Sciguy324/Big-Piano-2/Photos/StickyGuide.jpg

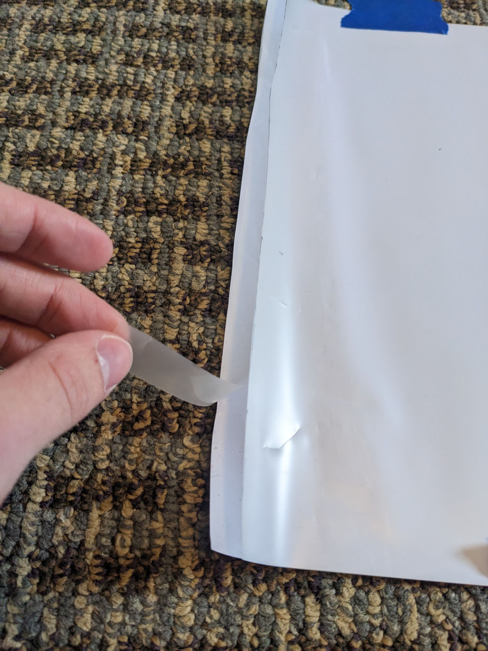
Photos/StickyGuide.jpg
