Sciguy324/Big-Piano-2/Photos/BoardBoxAssembly1.jpg

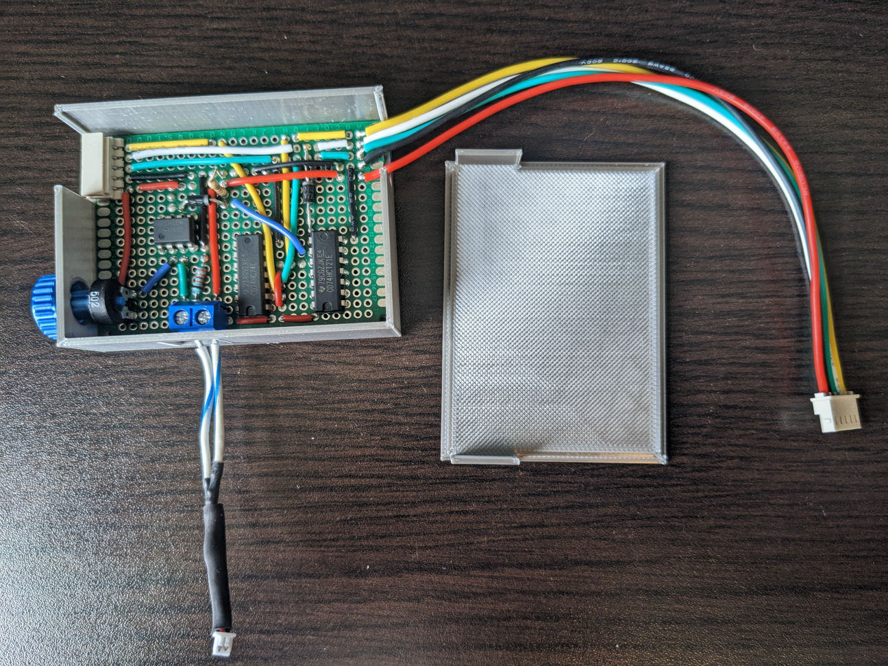
Photos/BoardBoxAssembly1.jpg
