Sciguy324/Big-Piano-2/README.md

# Big-Piano-2
Piano 2 - Electric Boogaloo

This repository contains code and documentation for the Larger Than Life Piano.
