Sciguy324/Big-Piano-2/Photos/BlackKey.jpg

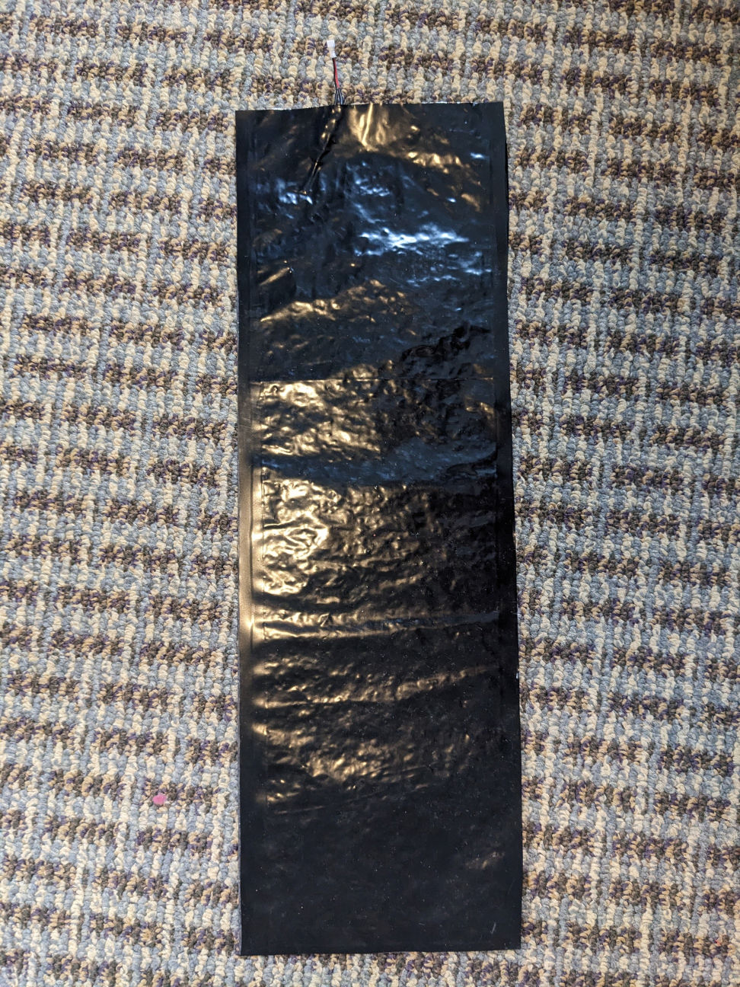
Photos/BlackKey.jpg
