Sciguy324/Big-Piano-2/Photos/BoardBottom.jpg

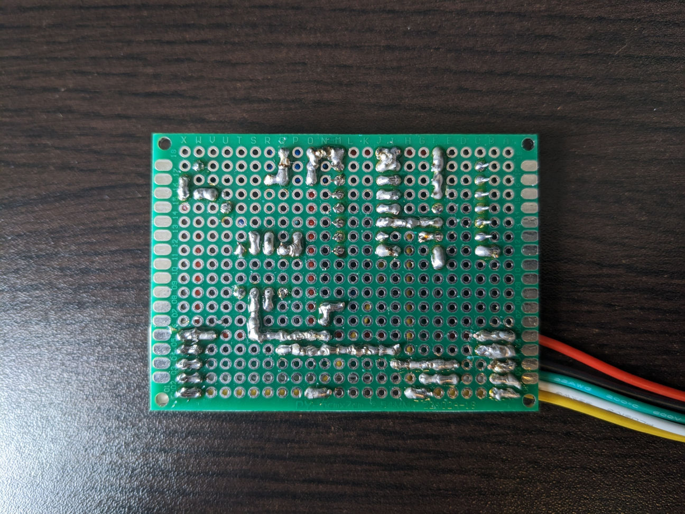
Photos/BoardBottom.jpg
