Sciguy324/Big-Piano-2/Photos/BoardBox.jpg

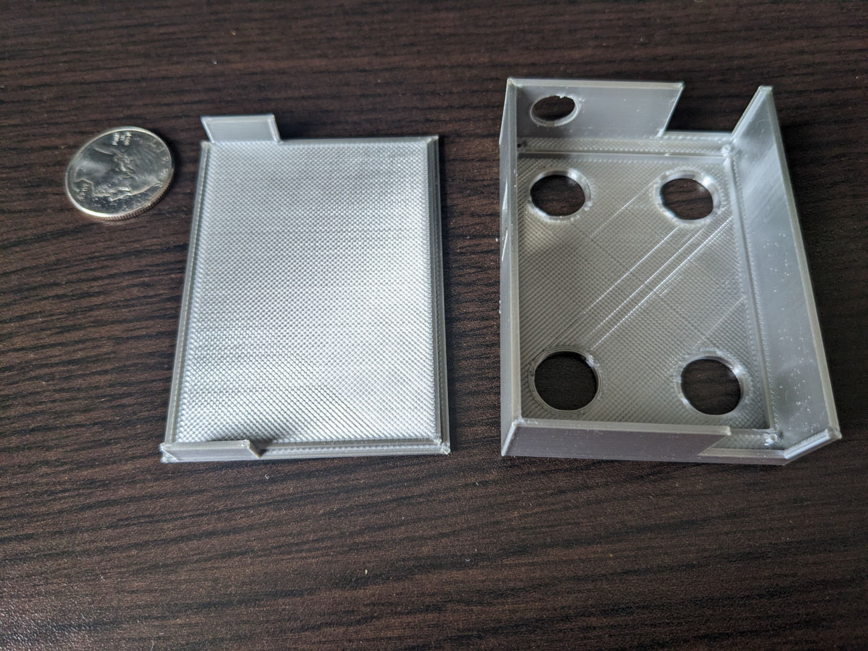
Photos/BoardBox.jpg
