Sciguy324/Big-Piano-2/Photos/BoardsConnected.jpg

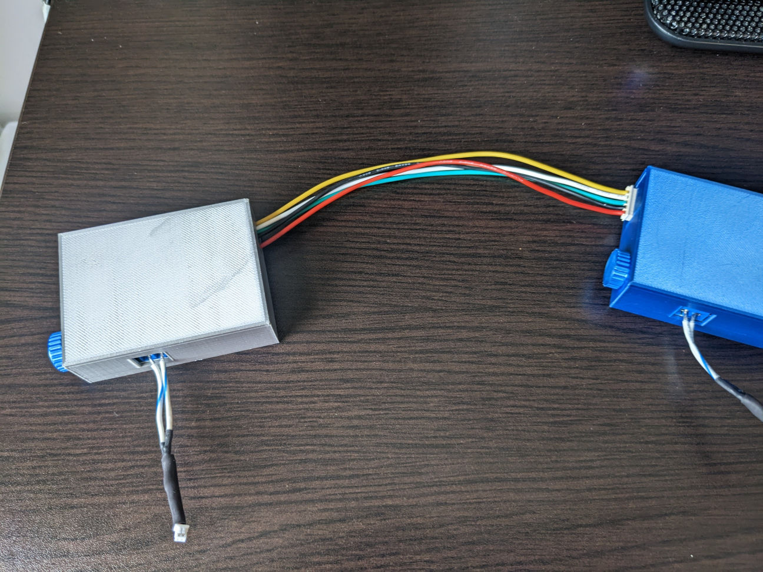
Photos/BoardsConnected.jpg
