Sciguy324/Big-Piano-2/Photos/BoardSide1.jpg

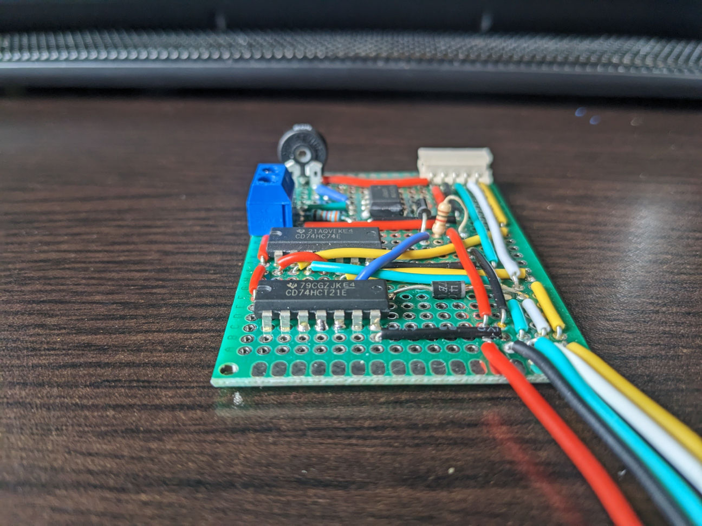
Photos/BoardSide1.jpg
