Sciguy324/Big-Piano-2/Photos/BoardSide2.jpg

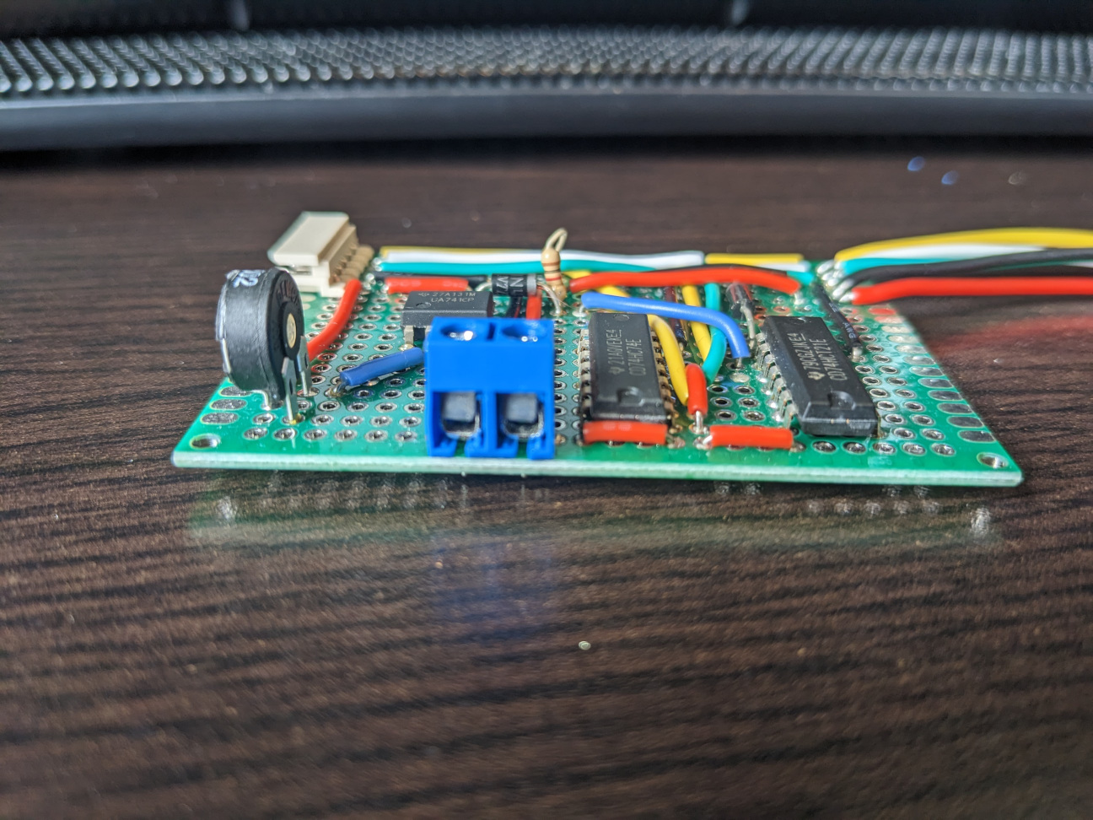
Photos/BoardSide2.jpg
