Sciguy324/Big-Piano-2/Photos/BoardSide3.jpg

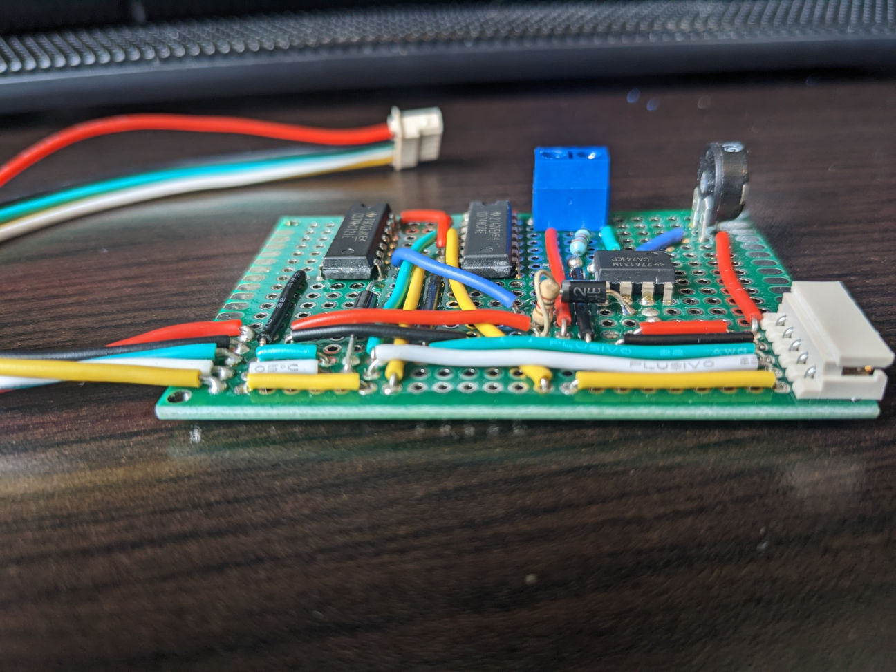
Photos/BoardSide3.jpg
