Sciguy324/Big-Piano-2/Photos/BoardSide4.jpg

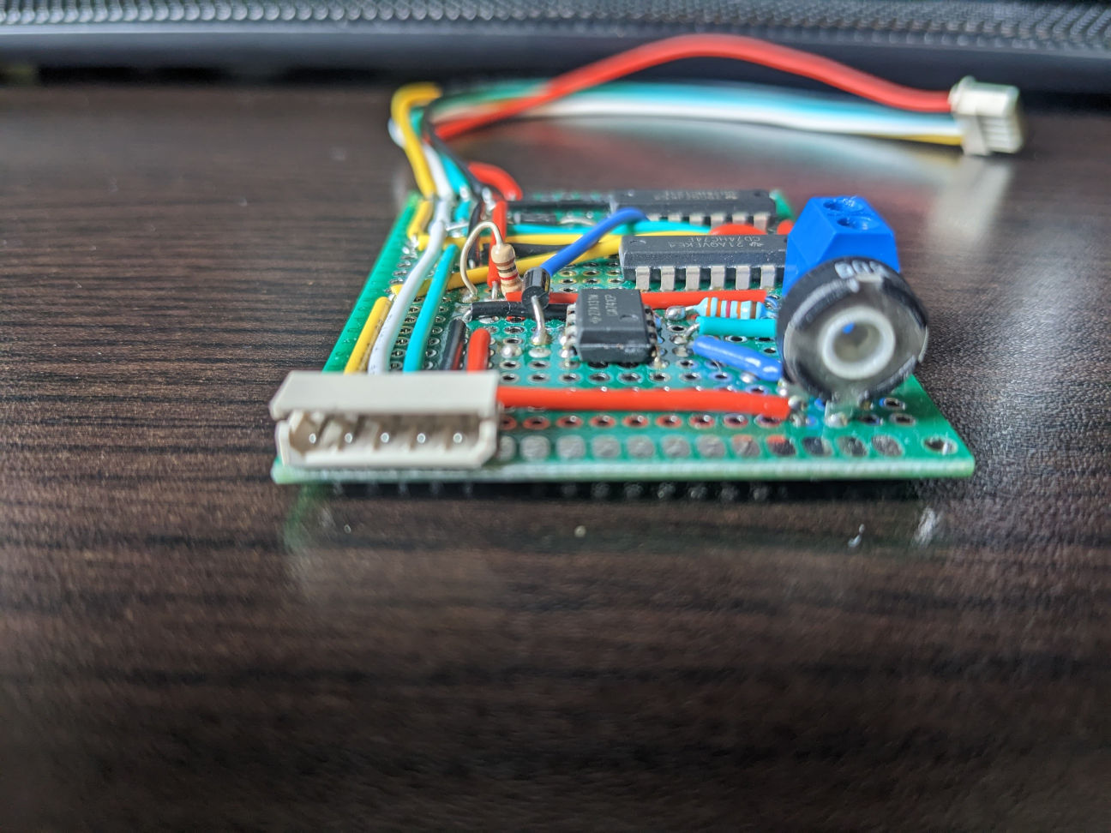
Photos/BoardSide4.jpg
