Sciguy324/Big-Piano-2/Photos/BoardTop1.jpg

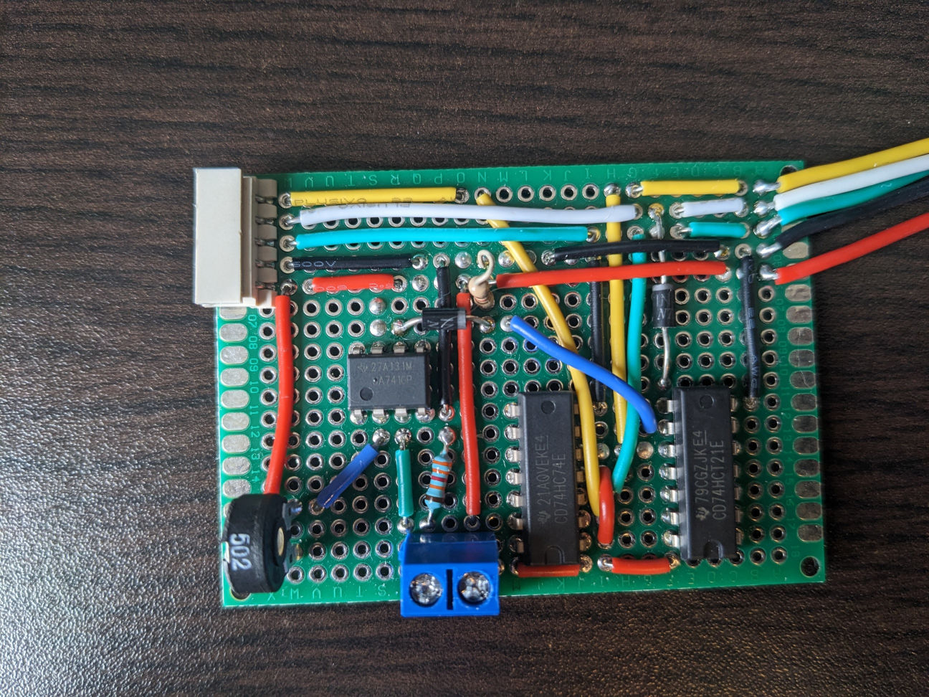
Photos/BoardTop1.jpg
