Sciguy324/Big-Piano-2/Photos/BoardTop2.jpg

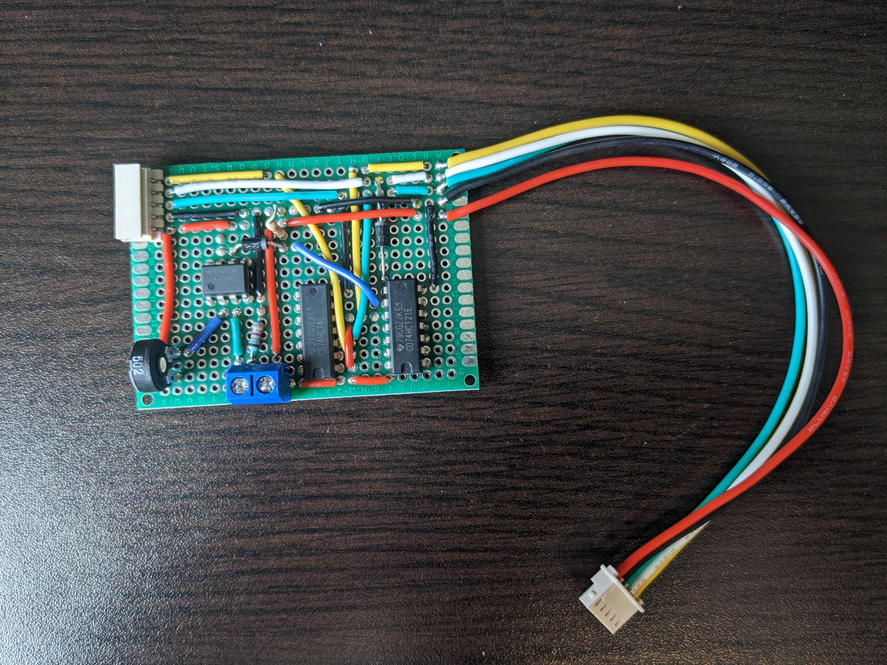
Photos/BoardTop2.jpg
