Sciguy324/Big-Piano-2/Photos/ControllerBottom.jpg

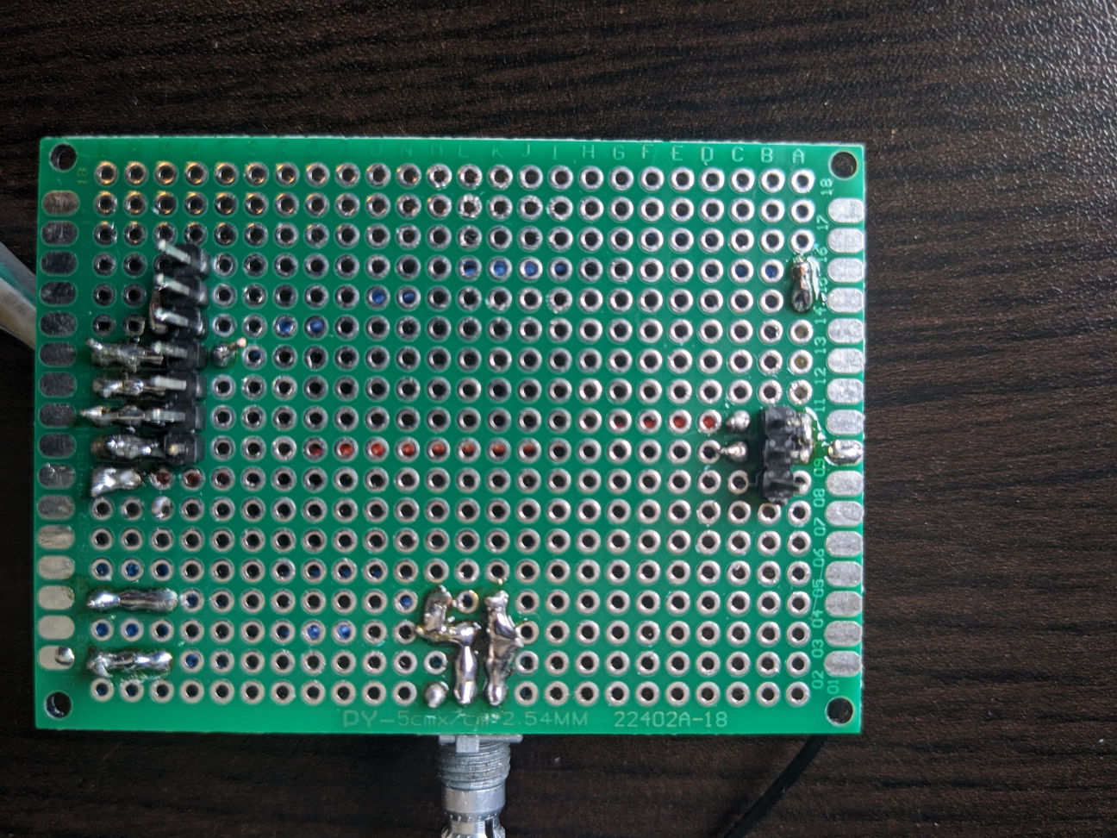
Photos/ControllerBottom.jpg
