Sciguy324/Big-Piano-2/Photos/ControllerConnected.jpg

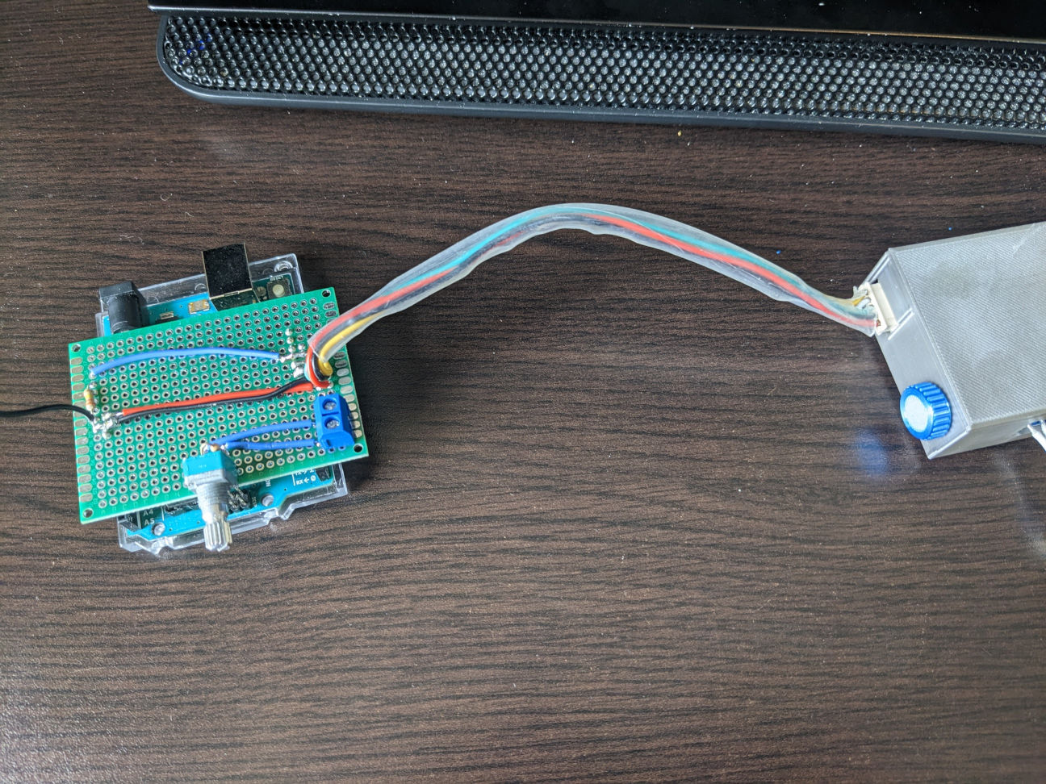
Photos/ControllerConnected.jpg
