Sciguy324/Big-Piano-2/Photos/ControllerSide1.jpg

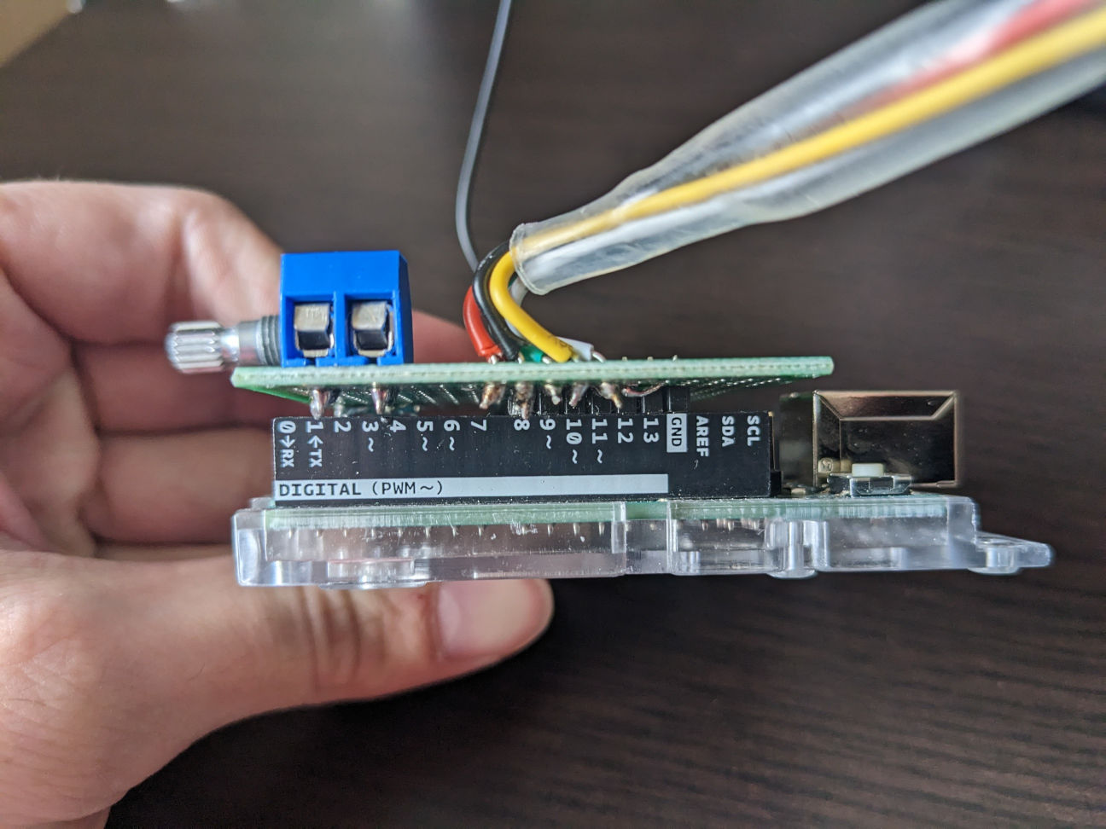
Photos/ControllerSide1.jpg
