Sciguy324/Big-Piano-2/Photos/ControllerSide2.jpg

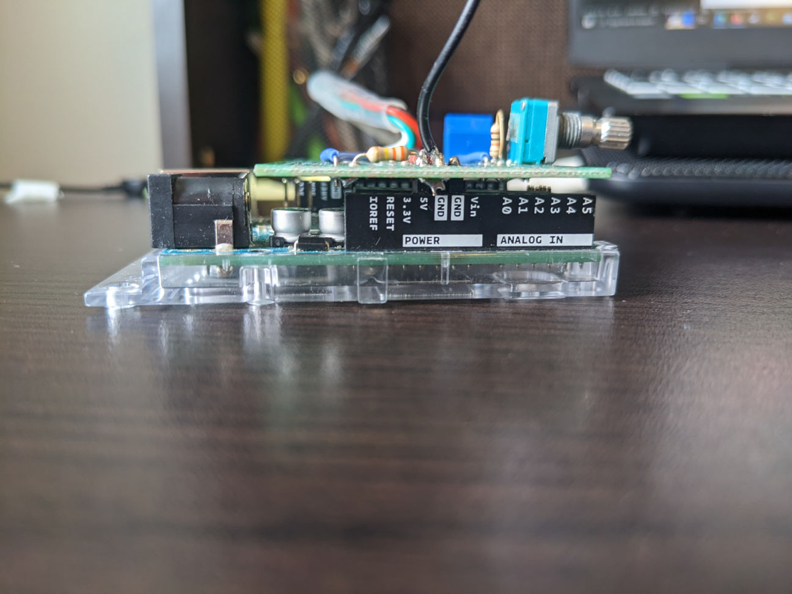
Photos/ControllerSide2.jpg
