Sciguy324/Big-Piano-2/Photos/ControllerTop.jpg

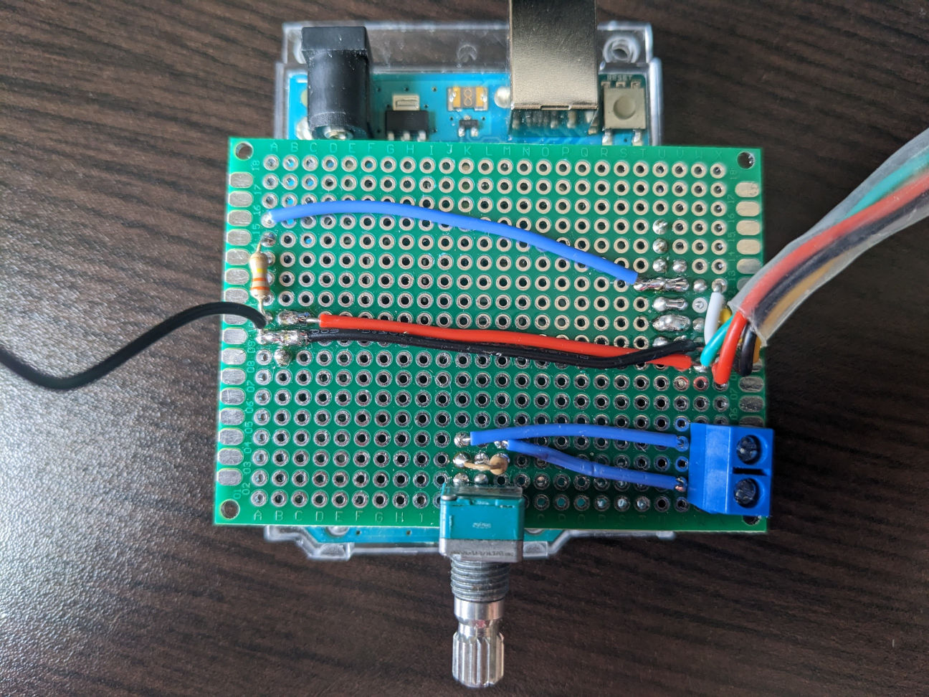
Photos/ControllerTop.jpg
