Sciguy324/Big-Piano-2/Photos/KeyConnect1.jpg

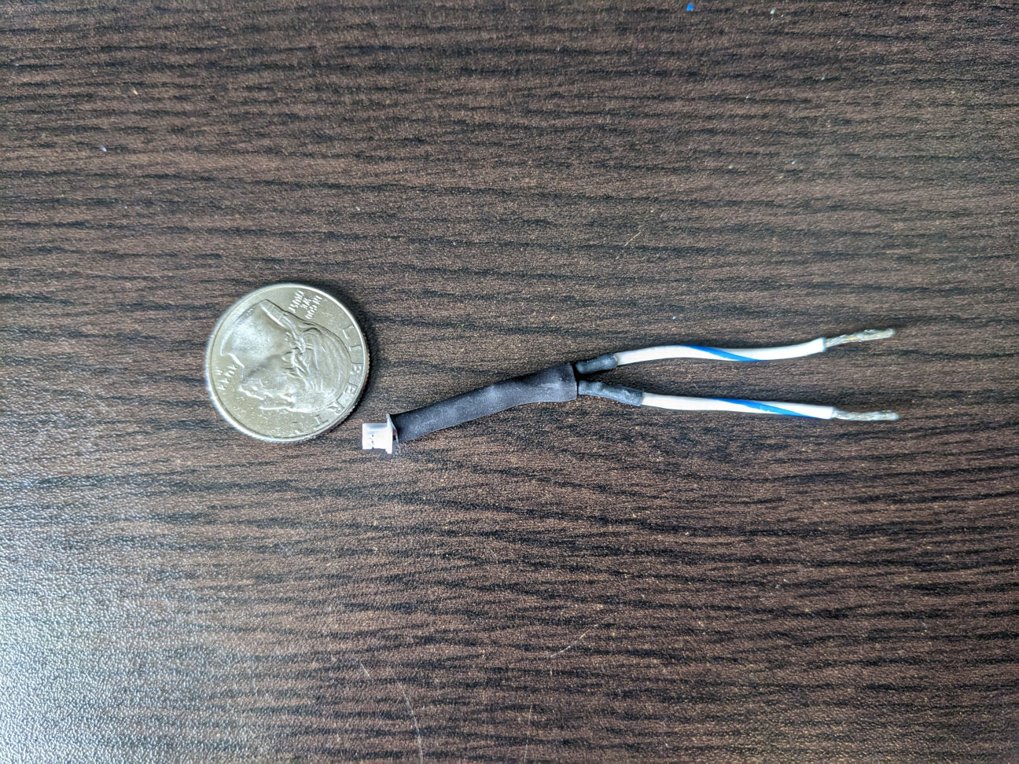
Photos/KeyConnect1.jpg
