Sciguy324/Big-Piano-2/Photos/KeyConnected1.jpg

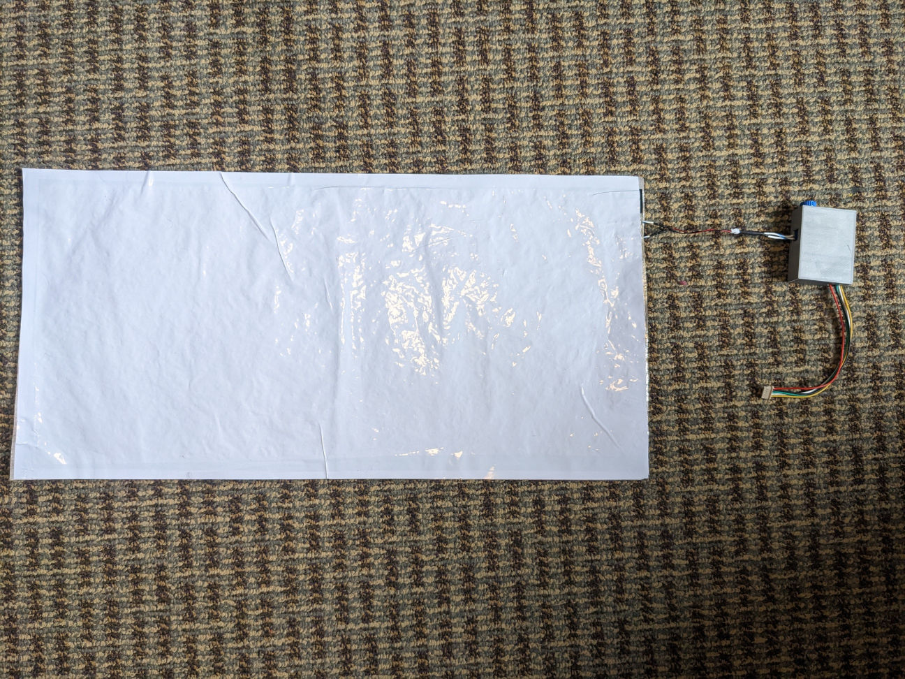
Photos/KeyConnected1.jpg
