Sciguy324/Big-Piano-2/Photos/KeyConnected2.jpg

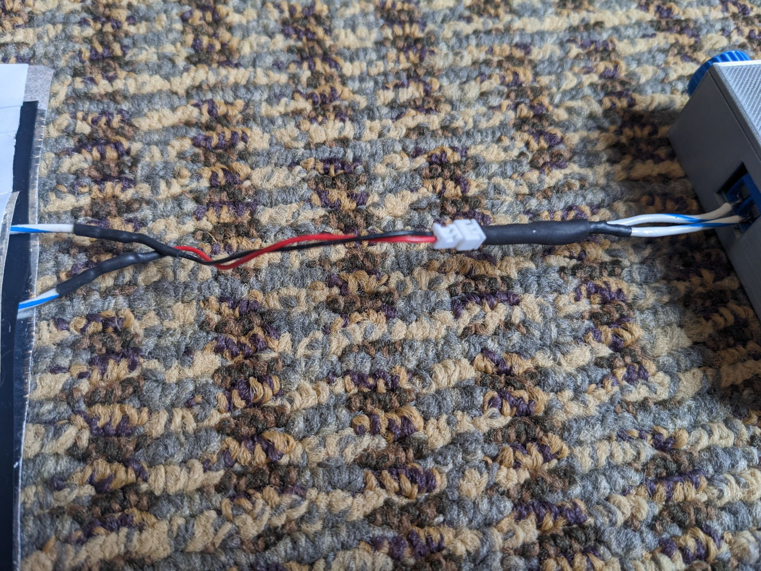
Photos/KeyConnected2.jpg
