Sciguy324/Big-Piano-2/Photos/KeyInside2.jpg

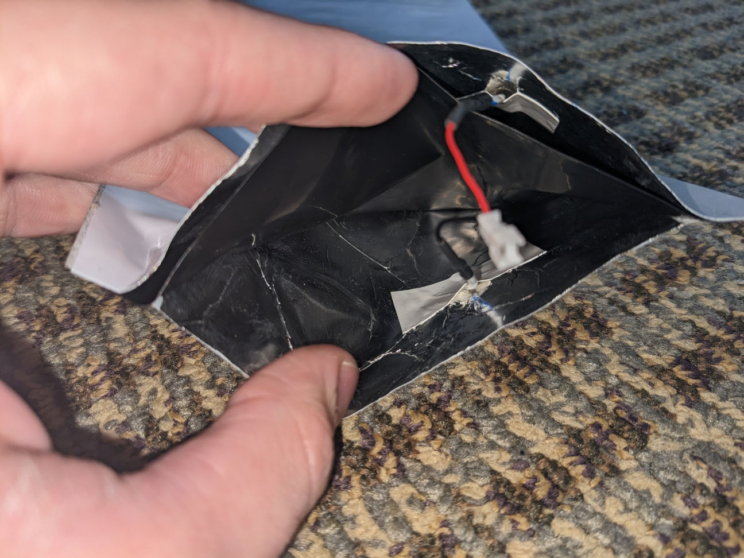
Photos/KeyInside2.jpg
