Sciguy324/Big-Piano-2/Photos/KeyInside.jpg

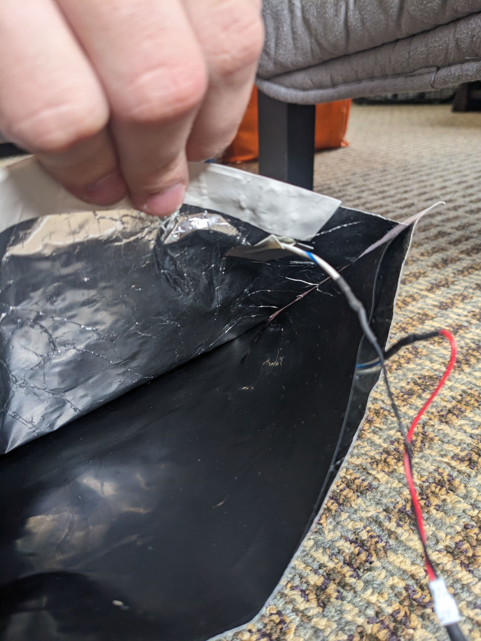
Photos/KeyInside.jpg
