Sciguy324/Big-Piano-2/Photos/Knob.jpg

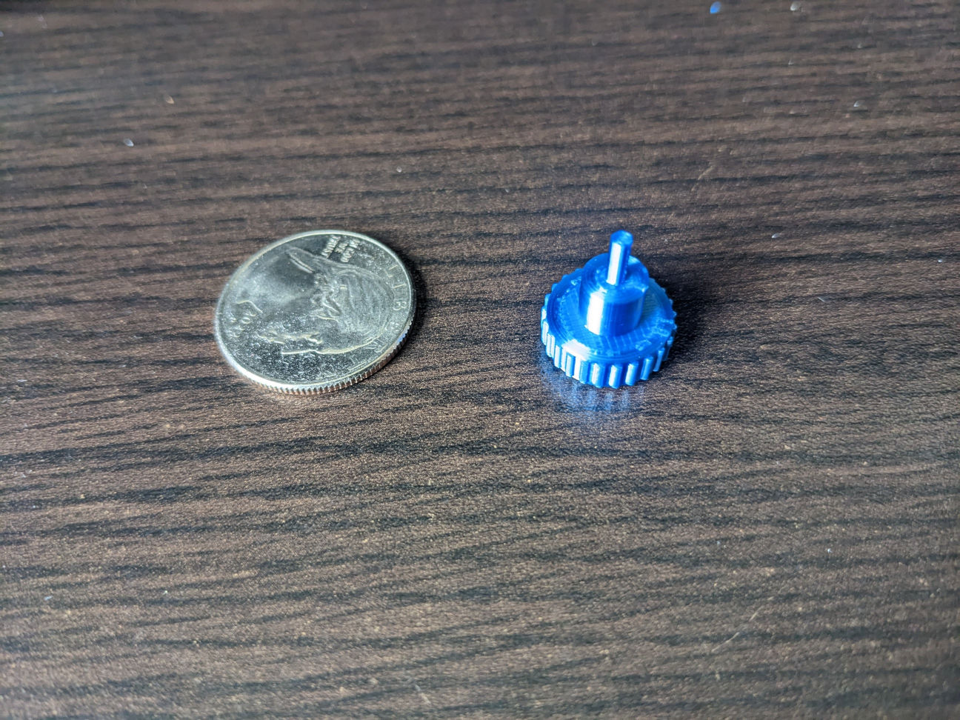
Photos/Knob.jpg
