Sciguy324/Big-Piano-2/Source Files/Initial Bill of Materials.xlsx

Name | Unit Cost | Quantity | Total Cost ($130.56) | Link
D Flip Flop | $0.59 | 14 | $8.26 | https://www.digikey.com/en/products/detail/texas-instruments/CD74HC74E/475948
AND Gate | $0.43 | 14 | $6.02 | https://www.digikey.com/en/products/detail/texas-instruments/CD74HCT21E/386074
Wood sheet |  |  | $0.00
Velostat | $4.95 | 15 | $74.25 | https://www.adafruit.com/product/1361
Op-Amps | $0.50 | 14 | $7.00 | https://www.digikey.com/en/products/detail/texas-instruments/UA741CP/382197
Potentiometers | $0.65 | 14 | $9.10 | https://www.digikey.com/en/products/detail/cui-devices/PTN10-A05HB20/16628492
Micro SD Card Module | $5.99 | 0 | $0.00 | https://www.amazon.com/AiTrip-Module-Conversion-Arduino-Adapter/dp/B07ZB9ZDHB/?th=1
Micro SD Card | $4.97 | 0 | $0.00 | https://www.amazon.com/Integral-UltimaPro-Class-Memory-Adapter/dp/B004IIA488/
Diodes | $0.00 | 14 | $0.00
JST 3-pin Connectors x13 | $9.99 | 1 | $9.99 | https://www.amazon.com/ALITOVE-Female-Connector-WS2812B-SK6812-RGBW/dp/B071H5XCN5/
JST 2-pin Connectors x13 | $7.99 | 1 | $7.99 | https://www.amazon.com/Letool%C2%AE30-1-25mm-Female-Connector-Cables/dp/B013JRWCBU/
Raspberry Pi Pico | $4.00 | 1 | $4.00 | https://www.adafruit.com/product/4864
Audio Amplifier | $3.95 | 1 | $3.95 | https://www.adafruit.com/product/2130
 |  |  | $0.00
 |  |  | $0.00
 |  |  | $0.00
