Sciguy324/Big-Piano-2/Source Files/Components/CD74HCT21 And Gate.png

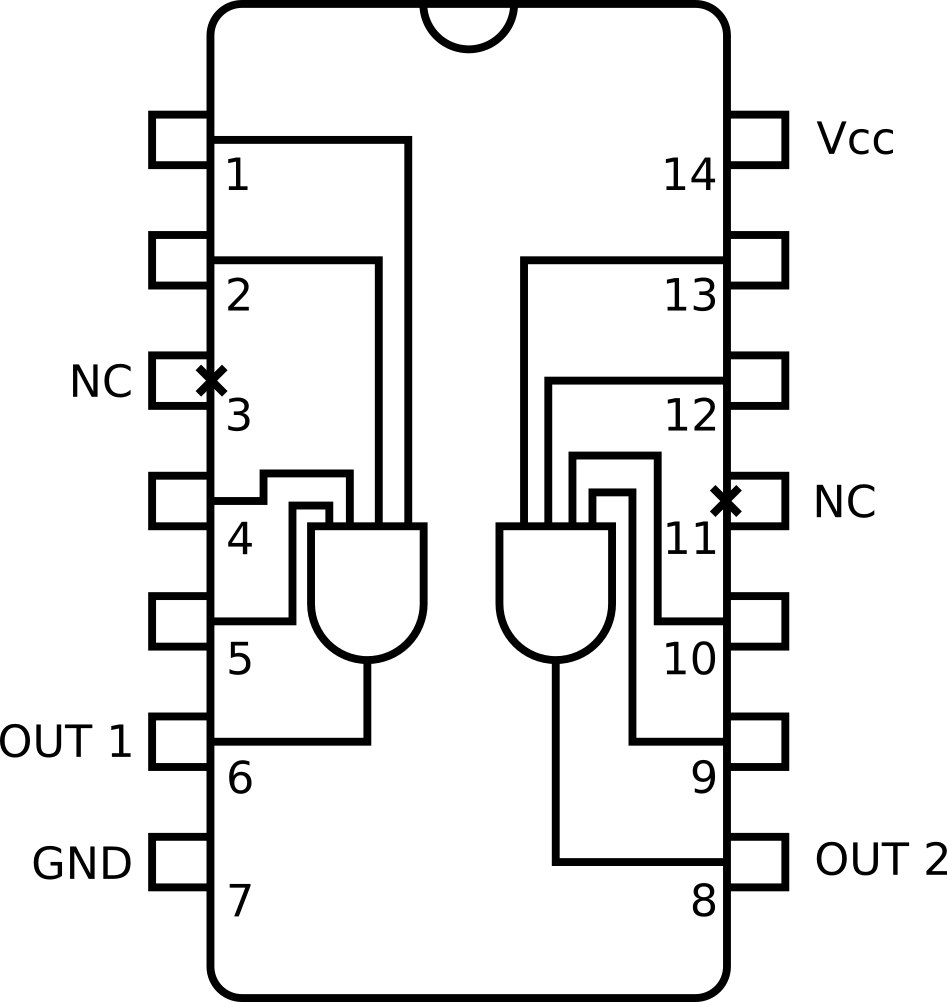
Source Files/Components/CD74HCT21 And Gate.png
