Sciguy324/Big-Piano-2/Models/Module Box Cover.stl

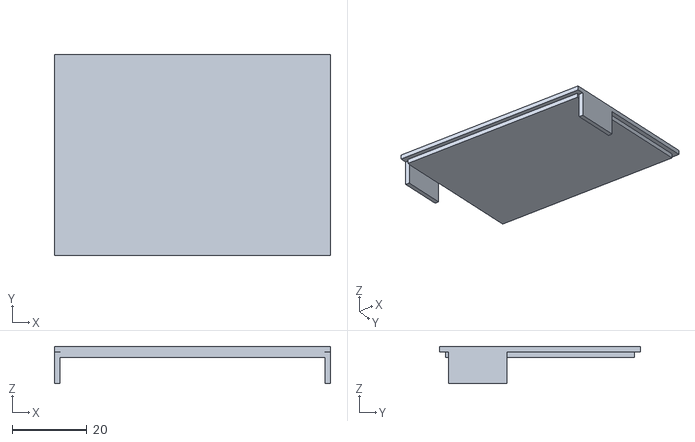
[picture p55: CAD file, 2023-05-07]
Models/Module Box Cover.stl
73.8 x 53.8 x 10.0
