Sciguy324/Big-Piano-2/Models/Module Box Base.stl

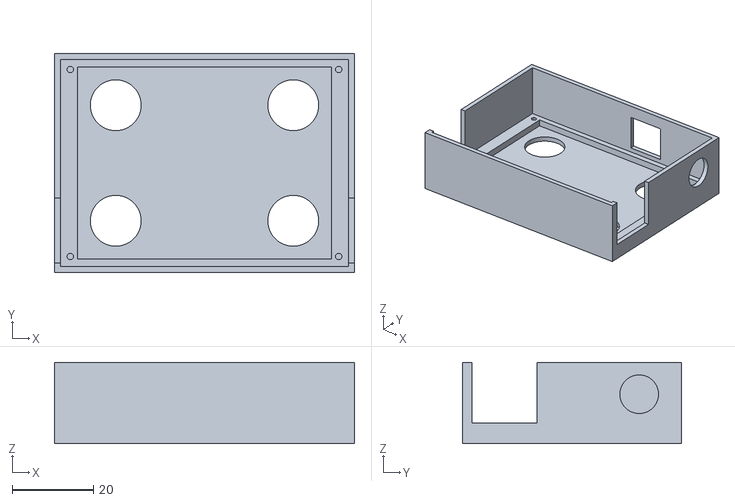
[picture p56: CAD file, 2023-05-07]
Models/Module Box Base.stl
73.8 x 53.8 x 20.0
