Sciguy324/Big-Piano-2/Models/Potentiometer Knob.stl

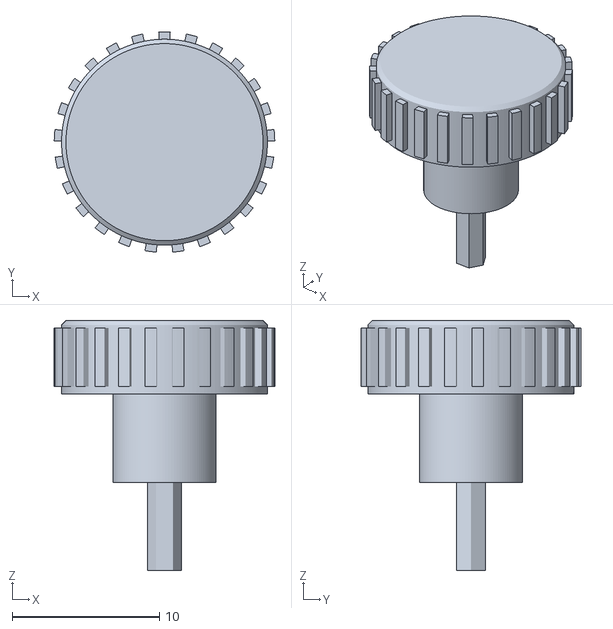
[picture p57: CAD file, 2023-05-07]
Models/Potentiometer Knob.stl
15.0 x 15.0 x 17.0
