Sciguy324/Big-Piano-2/(list of files, cad)

Other CAD files:
Models/Assembled Module Box.f3z
Models/Full Piano.f3z
