Sciguy324/Big-Piano-2/Photos/BoardBoxAssembly2.jpg

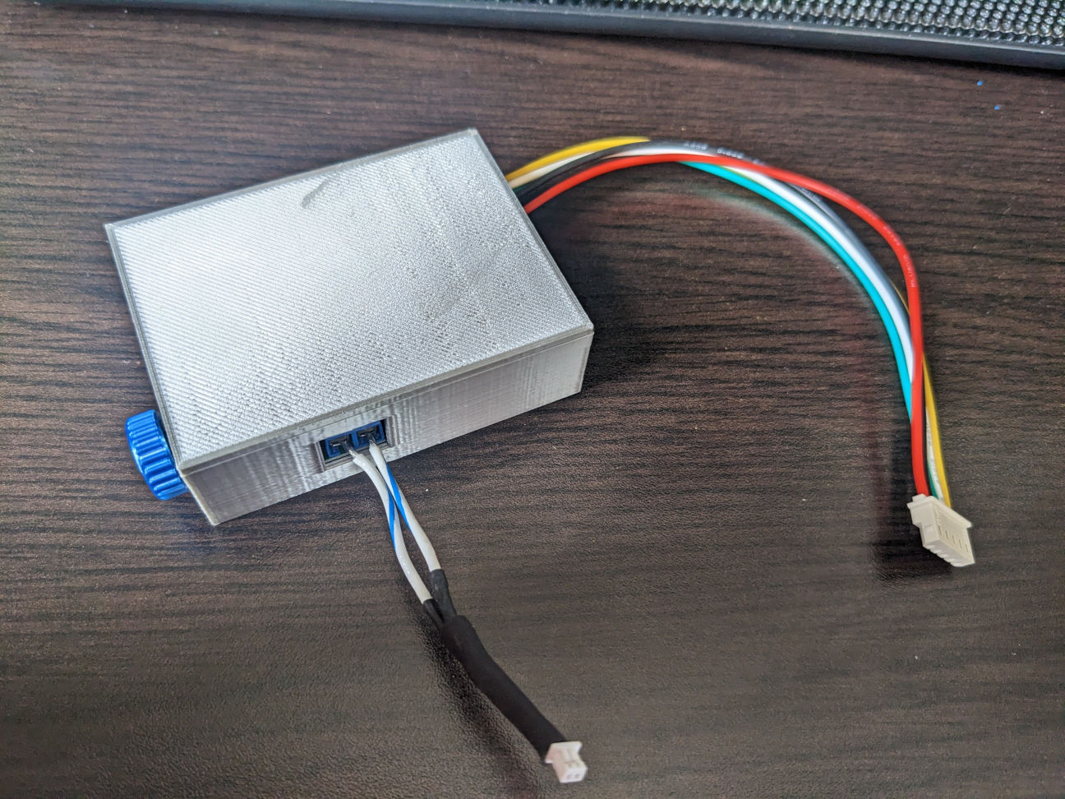
Photos/BoardBoxAssembly2.jpg
