Sciguy324/Big-Piano-2/Source Files/Arduino Setup.png

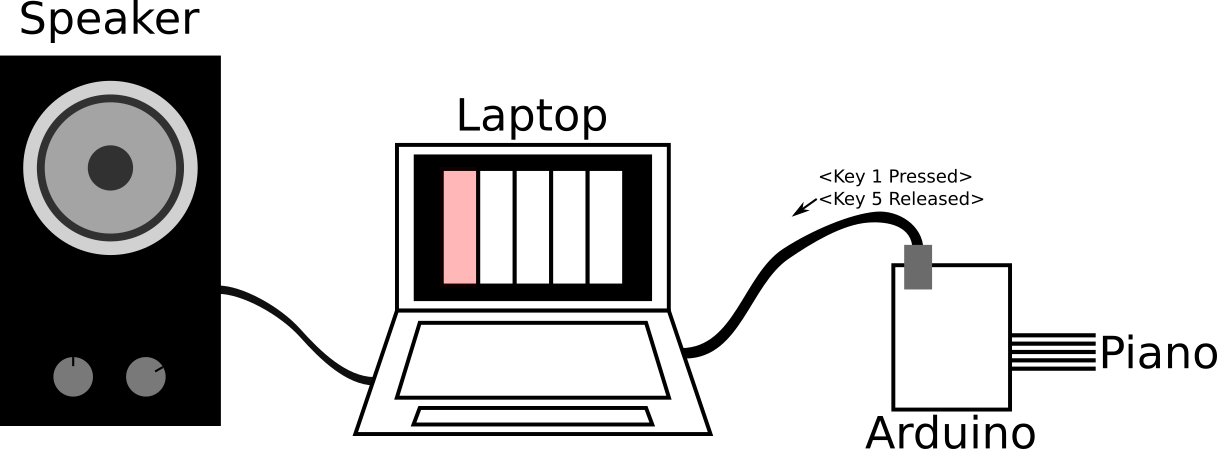
Source Files/Arduino Setup.png
