Sciguy324/Big-Piano-2/Source Files/Component Layout.pdf

D | CLK | DATA | SELECT SELECT DATA Vcc | CLK GND

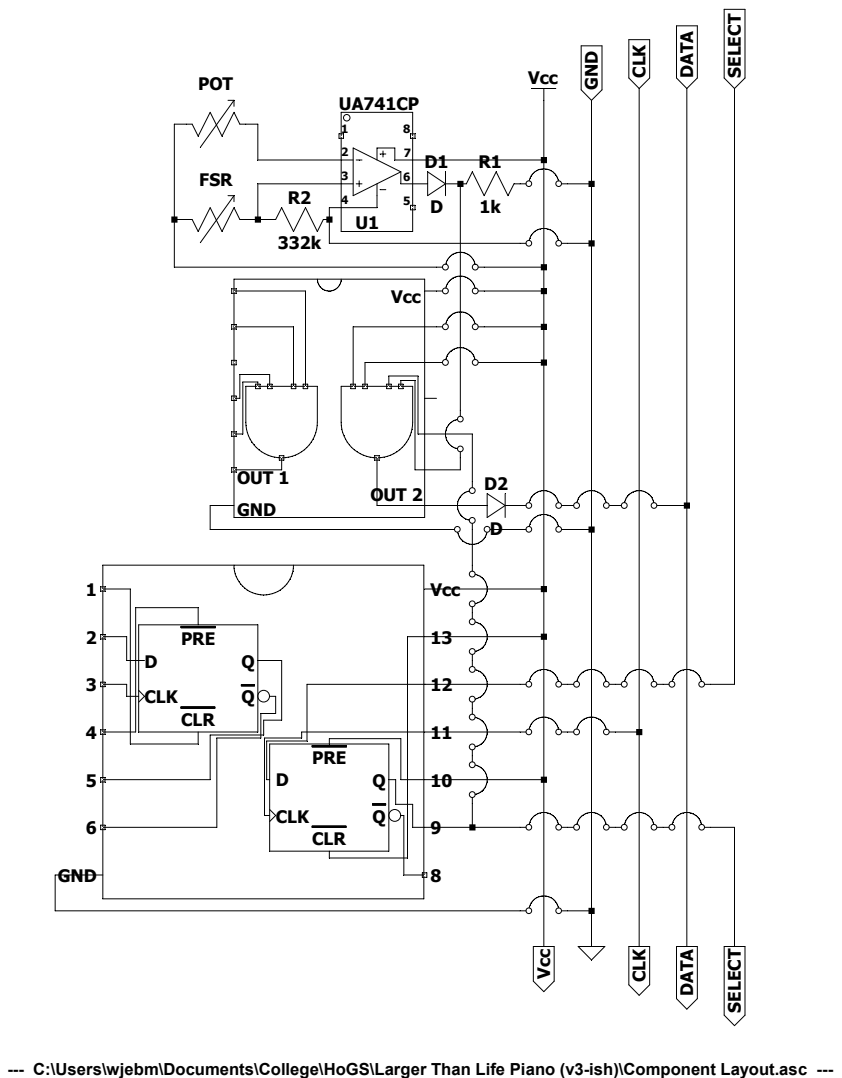
[picture p60: page 1]
GND; OUT 1; Vcc; OUT 2; CLR; PRE; CLK; POT; FSR

--- C:\Users\wjebm\Documents\College\HoGS\Larger Than Life Piano (v3-ish)\Component Layout.asc ---
