Sciguy324/Big-Piano-2/Source Files/Circuit Diagram.pdf

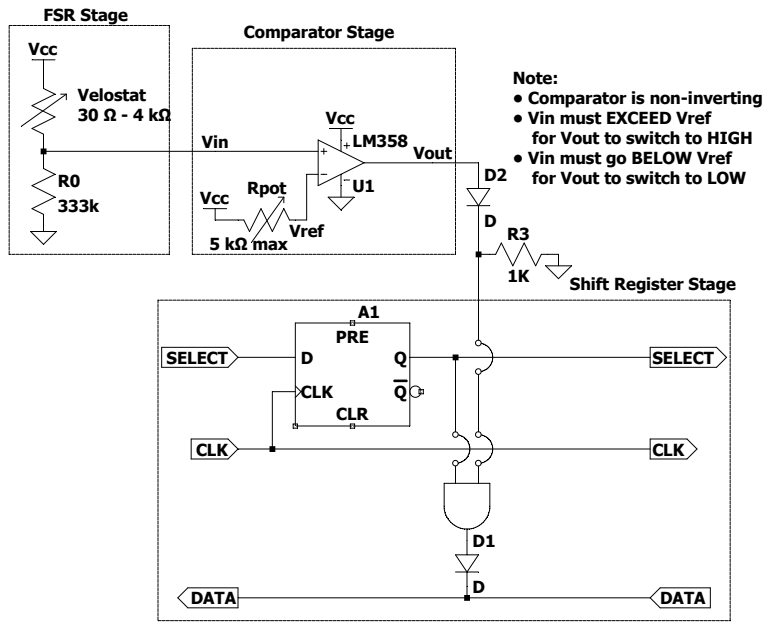
[picture p61: page 1]
Velostat; Vcc; Rpot Vcc; CLK; PRE; CLR; SELECT; DATA; Vin; Vref; Vout; FSR Stage; Comparator Stage; 5 kΩ max

Note:
• Comparator is non-inverting
• Vin must EXCEED Vref
for Vout to switch to HIGH
• Vin must go BELOW Vref
for Vout to switch to LOW

Shift Register Stage
