Sciguy324/Big-Piano-2/Source Files/Module Box Drawing.pdf

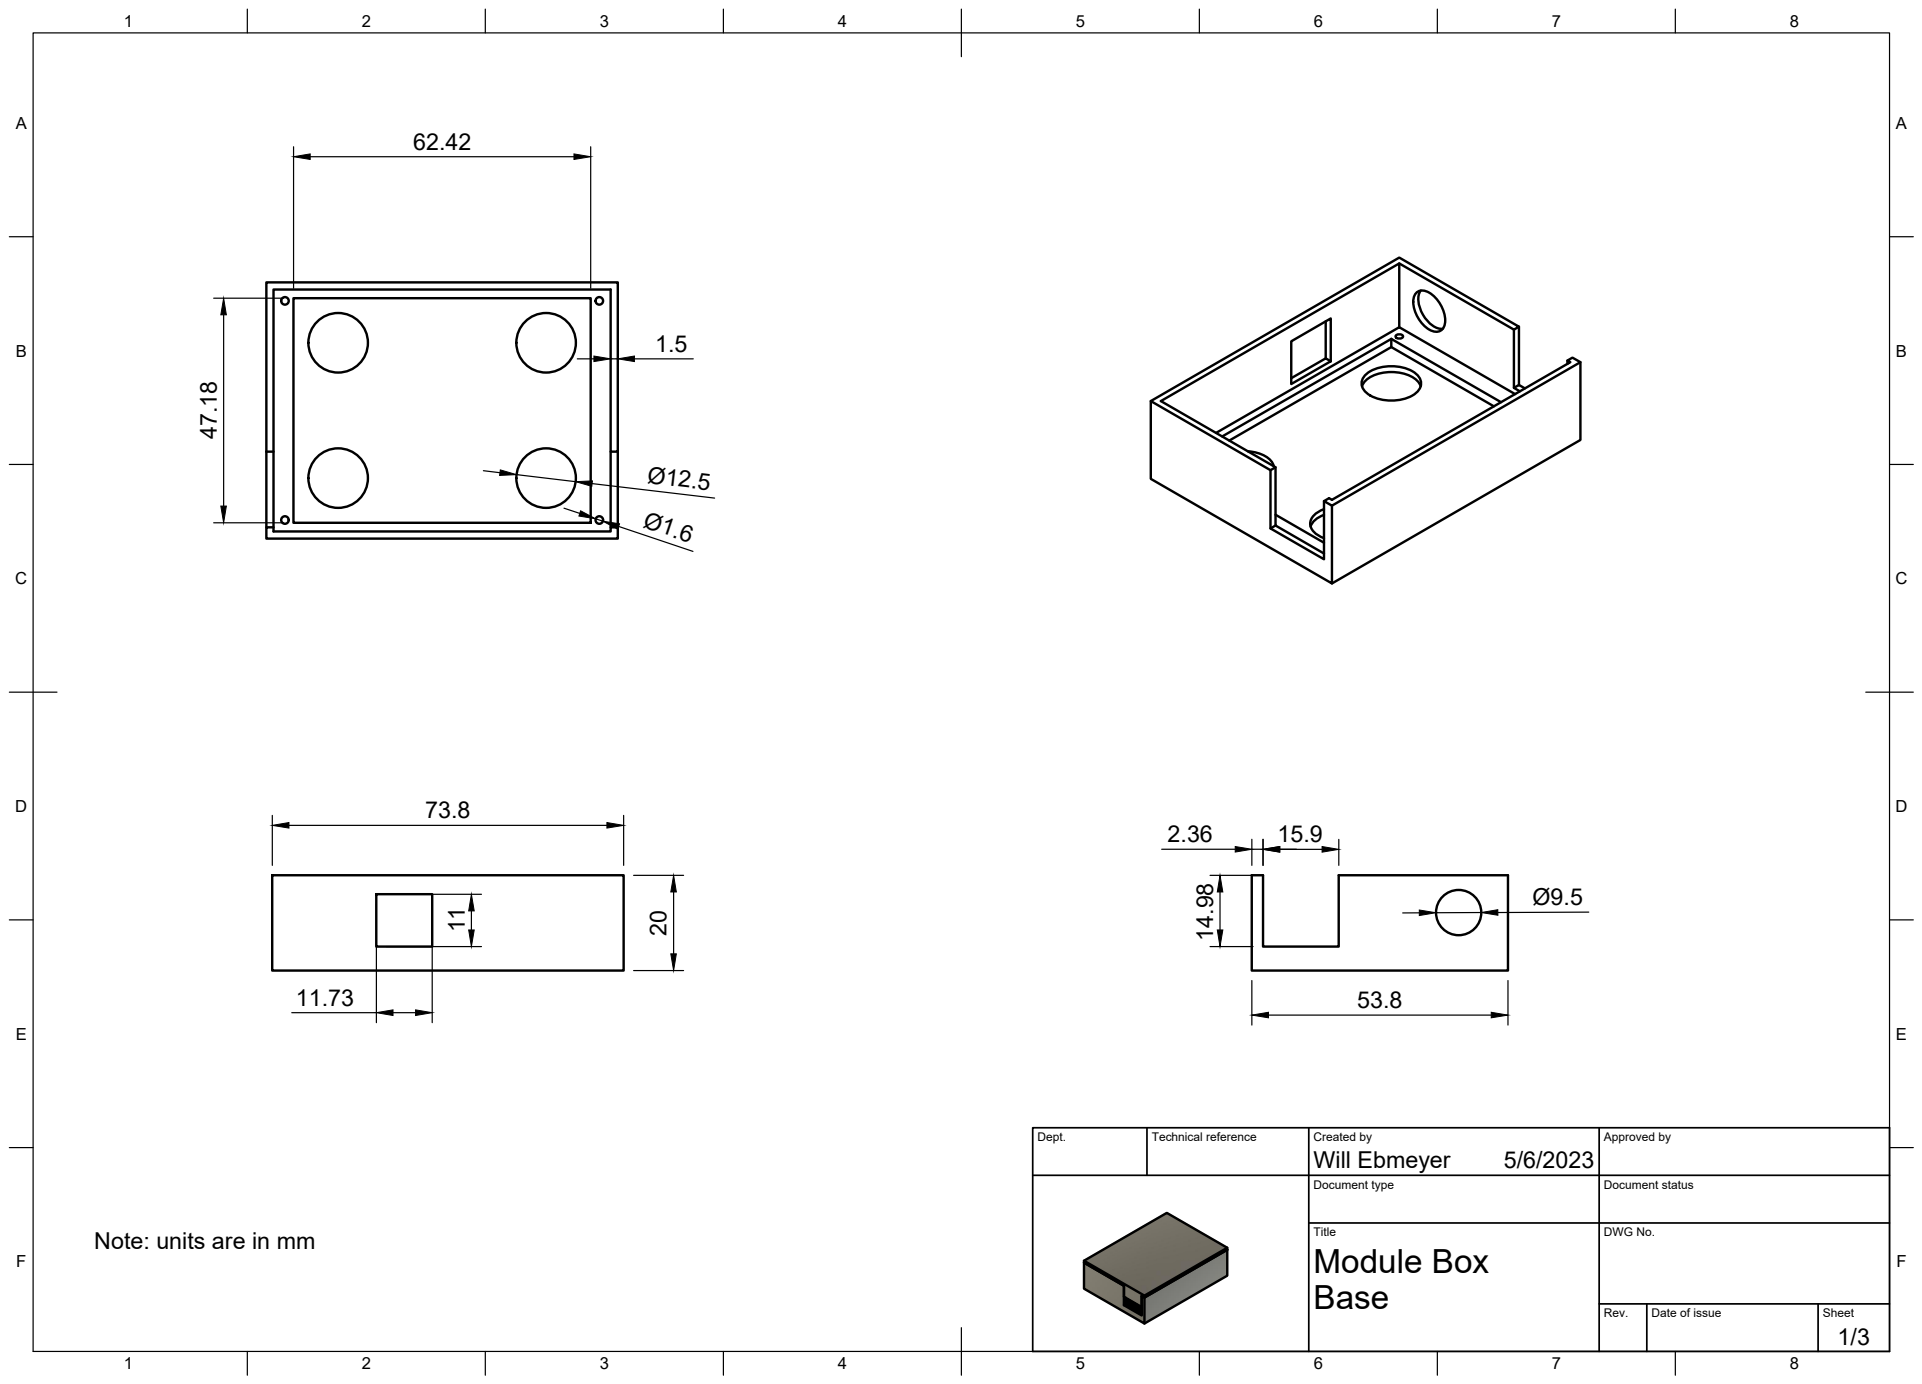
[picture p62: page 1]
Title; DWG No.; Rev.; Date of issue; Sheet; Module Box

Dept. | Technical reference | Created by Will Ebmeyer 5/6/2023 | Approved by

Document type | Document status

Note: units are in mm

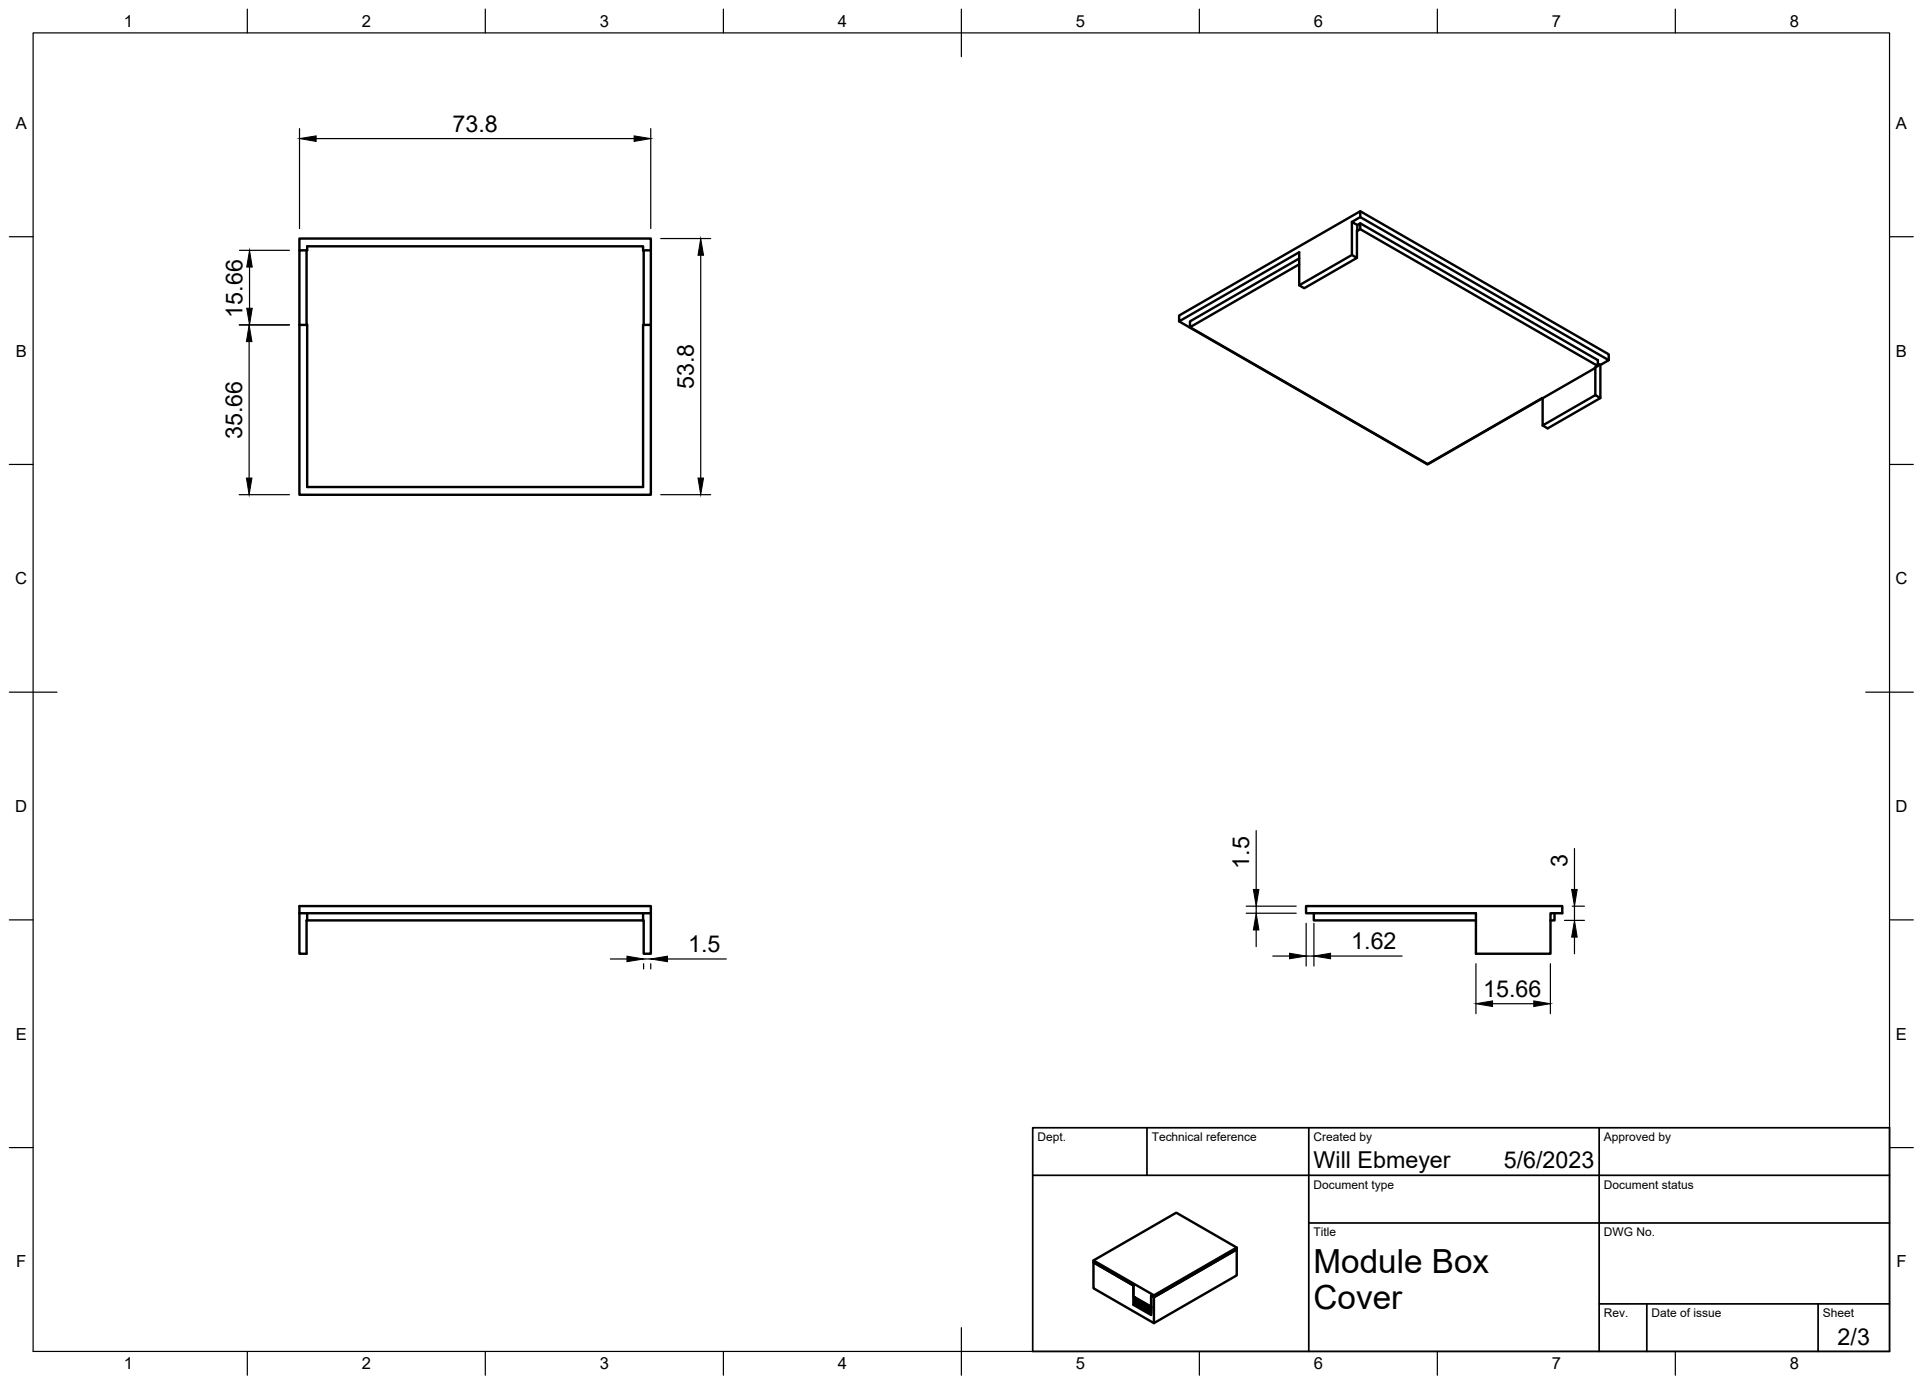
[picture p63: page 2]
Title; DWG No.; Module Box

Dept. | Technical reference | Created by Will Ebmeyer 5/6/2023 | Approved by

Document type | Document status

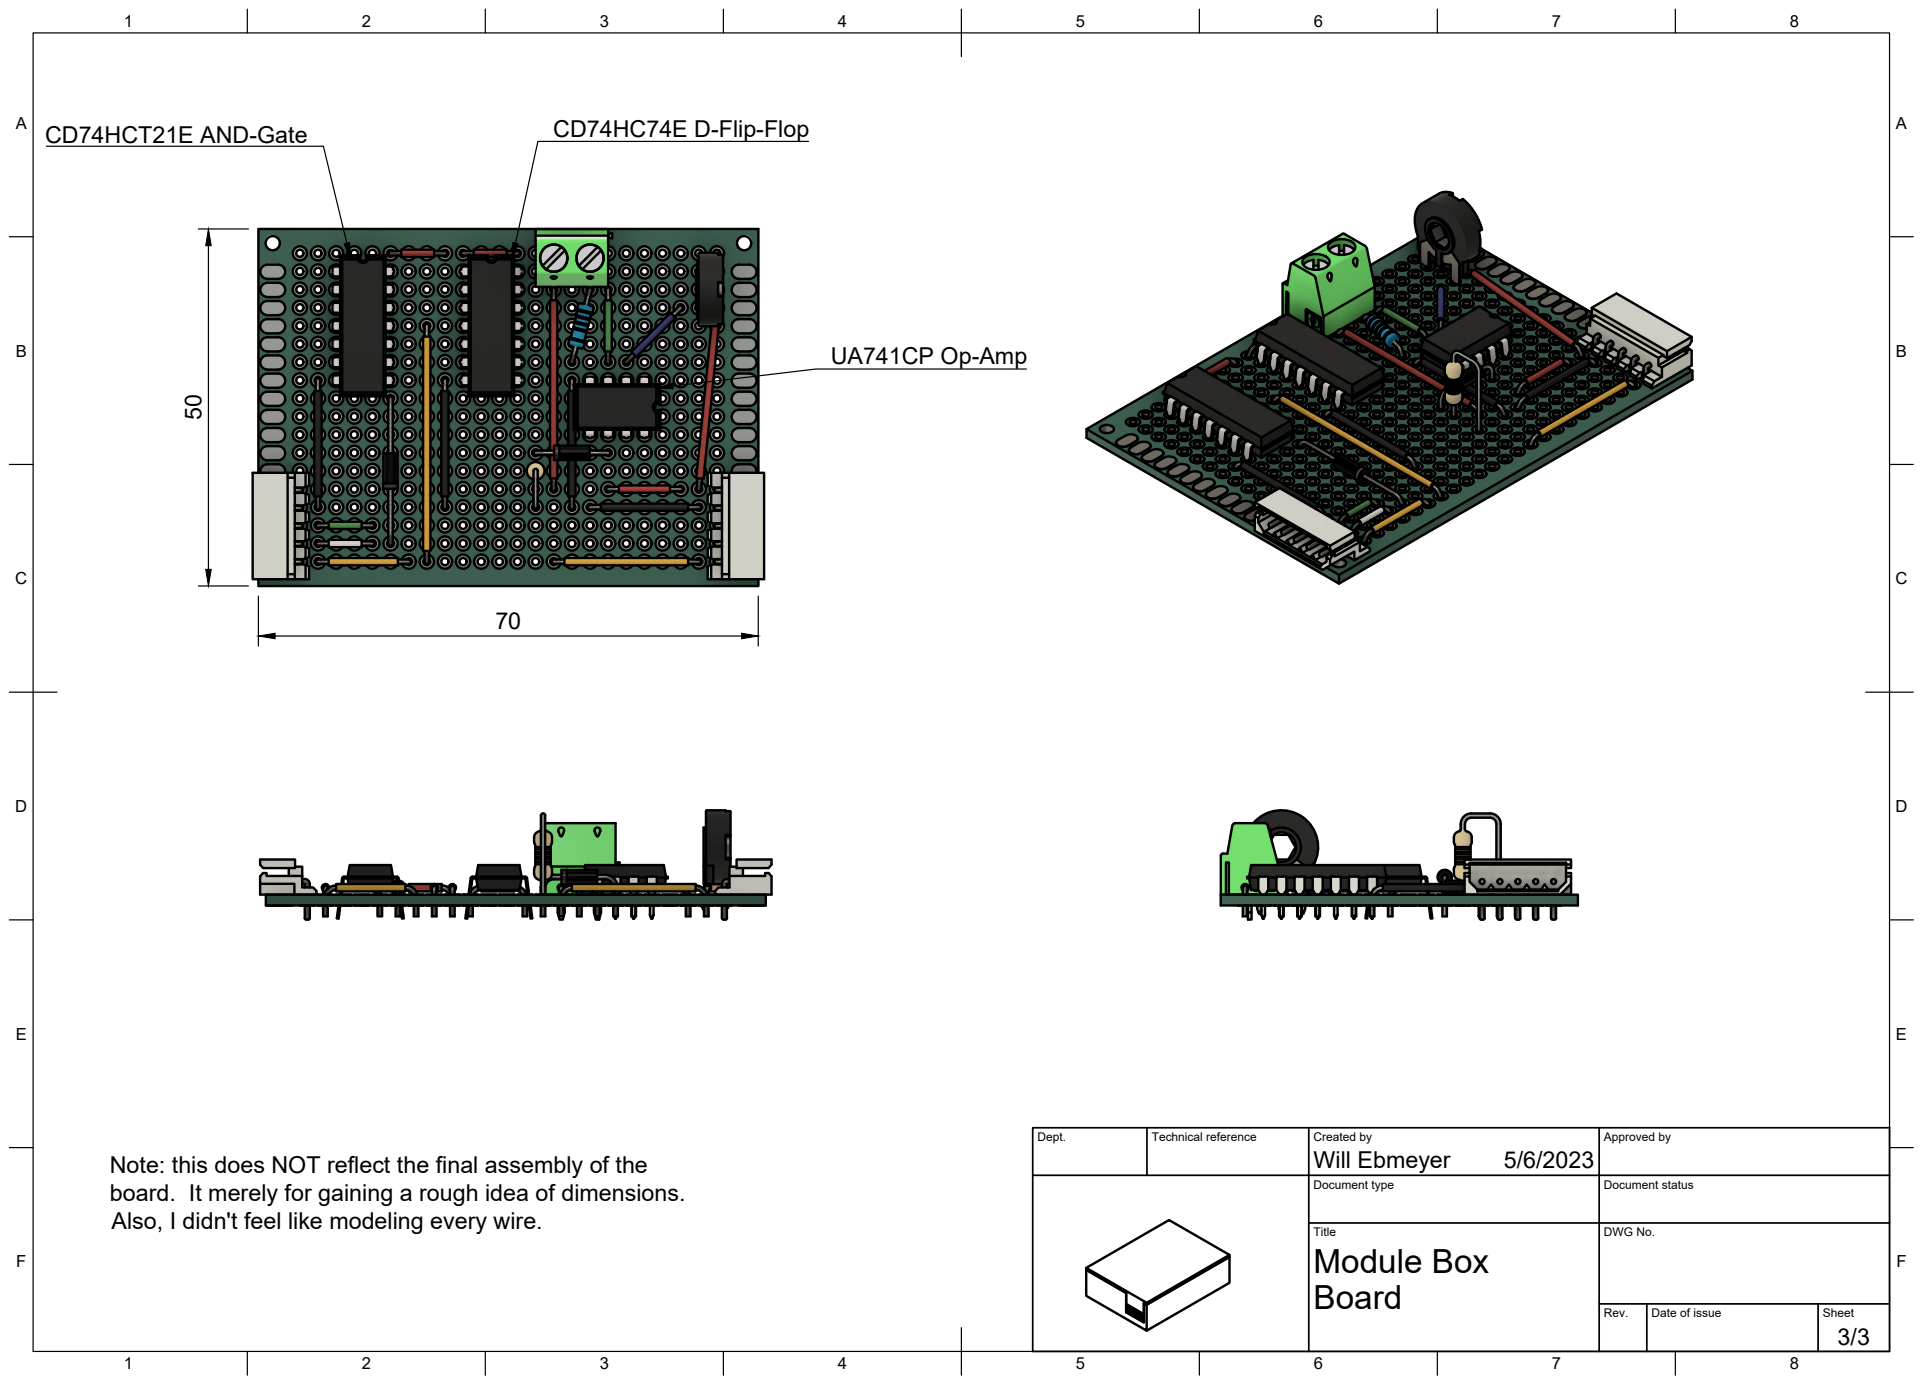
[picture p64: page 3]
Dept.; Technical reference; Created by; Approved by; Document type; Document status; Title; DWG No.; Module Box; Note: this does NOT reflect the final assembly of the; Will Ebmeyer; UA741CP Op-Amp; CD74HCT21E AND-Gate; CD74HC74E D-Flip-Flop

Also, I didn't feel like modeling every wire. 50

board. It merely for gaining a rough idea of dimensions.
