Sciguy324/Big-Piano-2/Source Files/All Exploded Keys Drawing.pdf

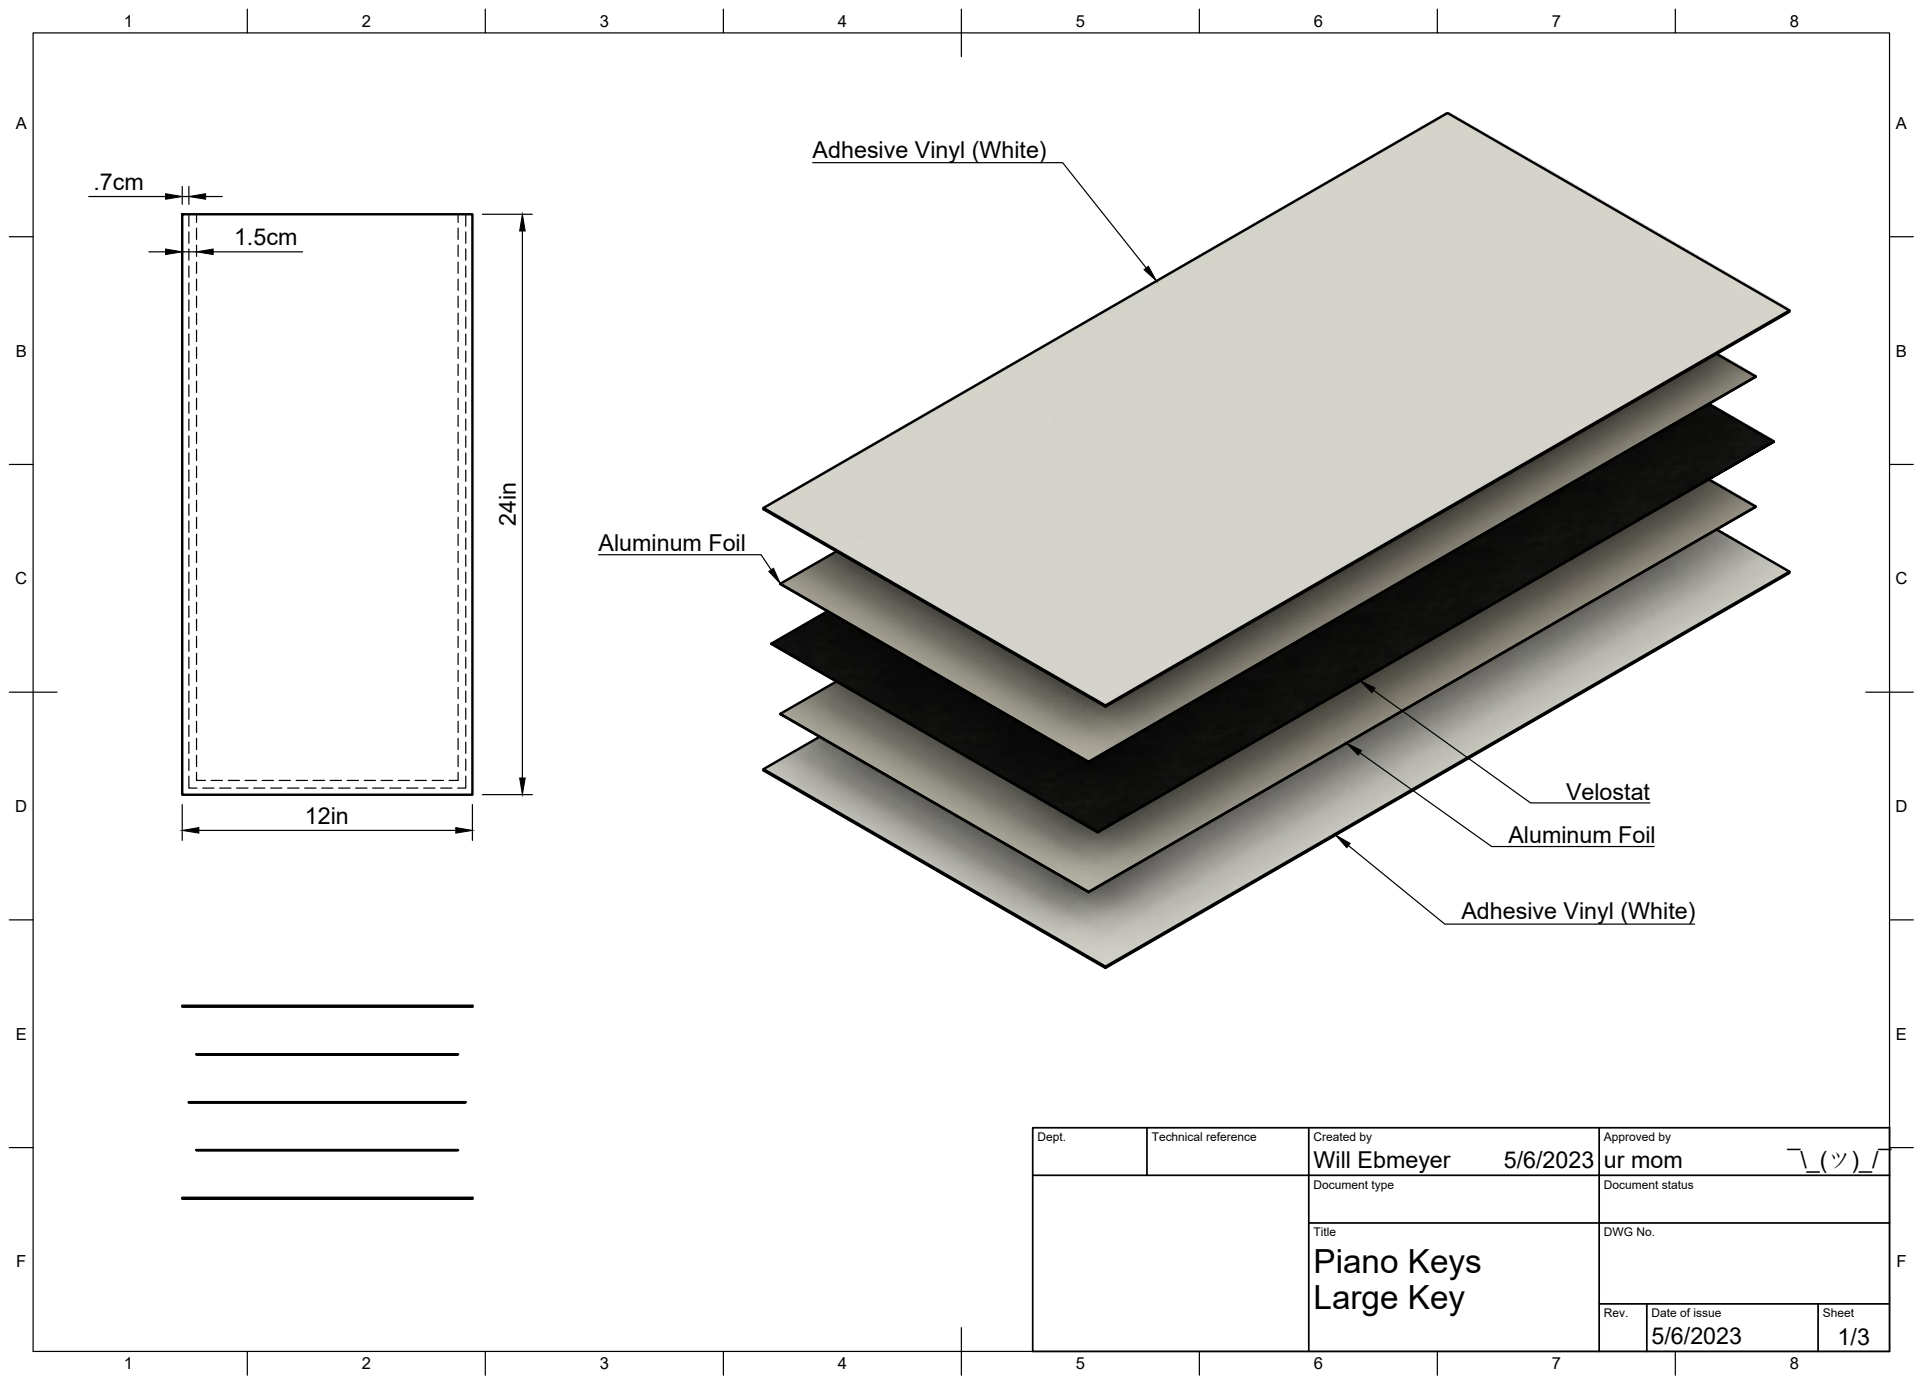
[picture p65: page 1]
Title; DWG No.; Rev.; Date of issue; Sheet; Large Key; Piano Keys; Aluminum Foil

Adhesive Vinyl (White)

Dept. | Technical reference | Created by Will Ebmeyer 5/6/2023 | Approved by ur mom ¯\_(ツ)_/¯

Document type | Document status

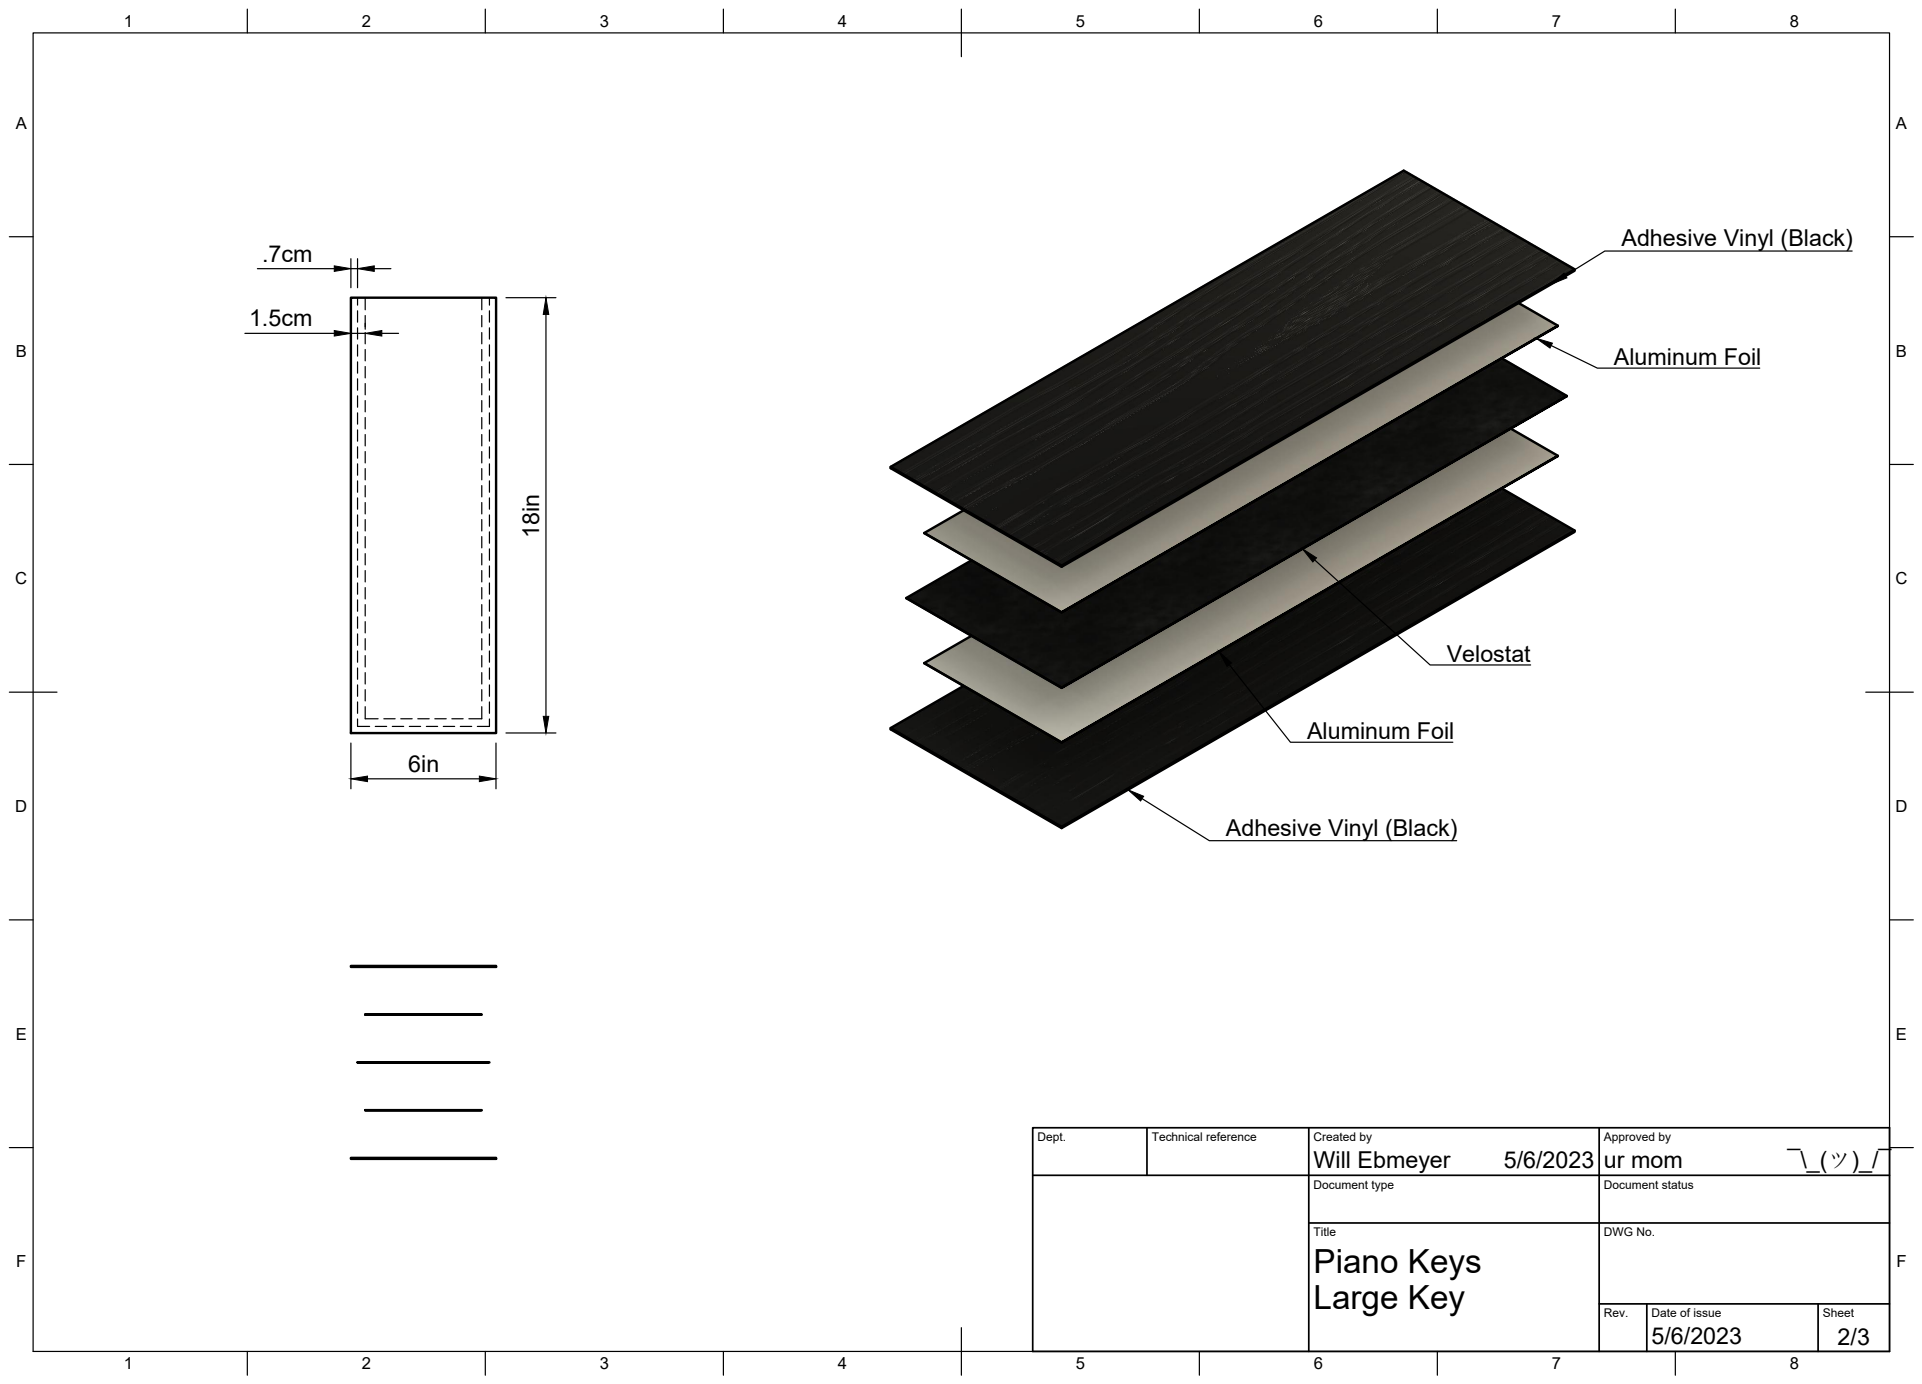
[picture p66: page 2]
Title; DWG No.; Large Key; Piano Keys; Aluminum Foil

Adhesive Vinyl (Black) 18in

Adhesive Vinyl (Black)

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

Document type | Document status

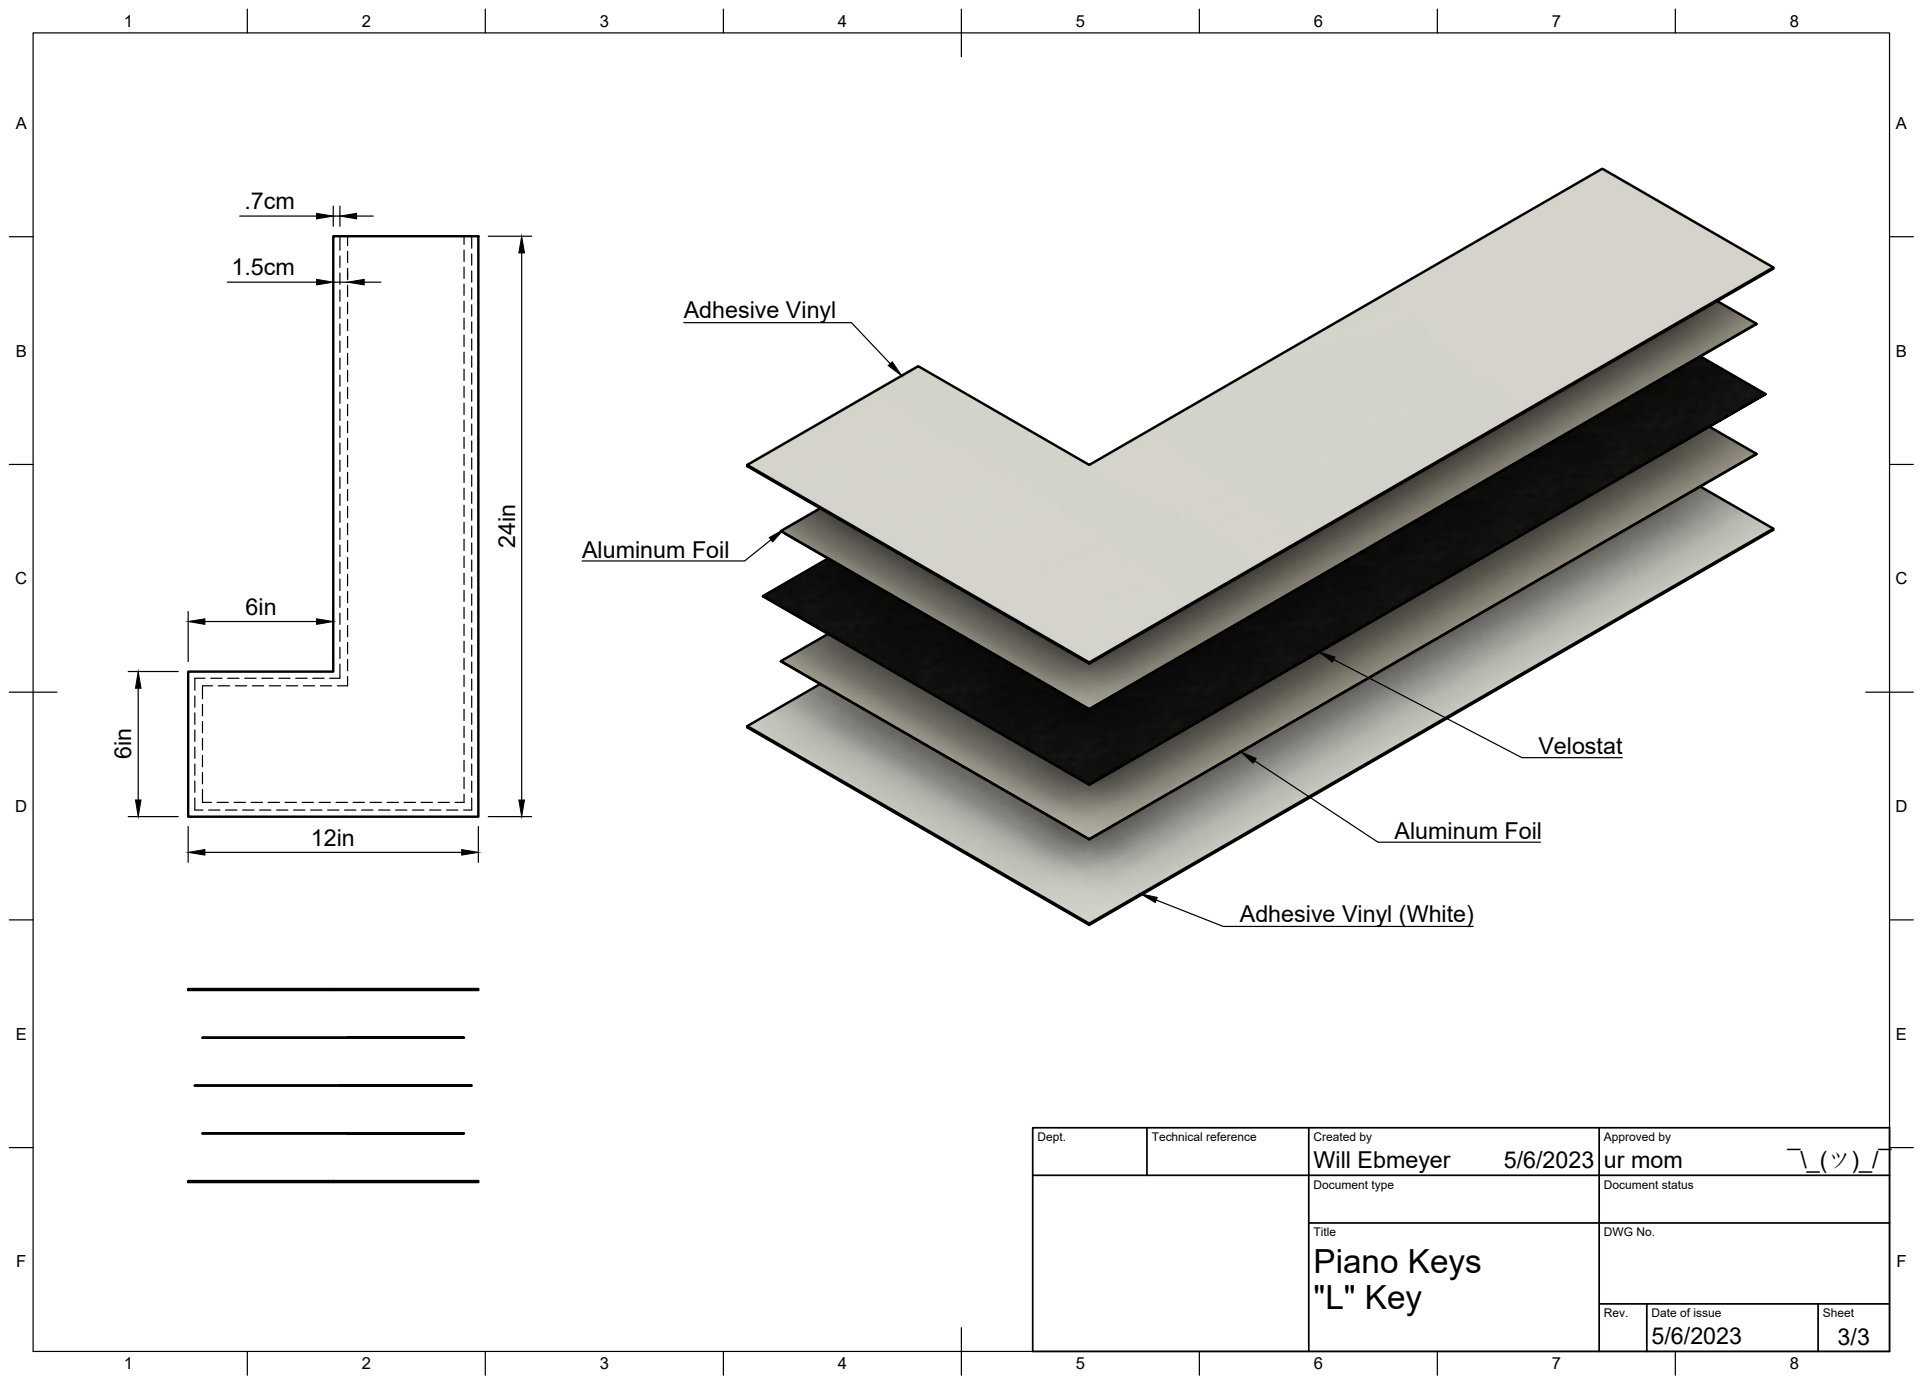
[picture p67: page 3]
Title; DWG No.; "L" Key; Piano Keys; Aluminum Foil; Adhesive Vinyl

Adhesive Vinyl (White)

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

Document type | Document status
