Sciguy324/Big-Piano-2/Source Files/Full Piano Drawing.pdf

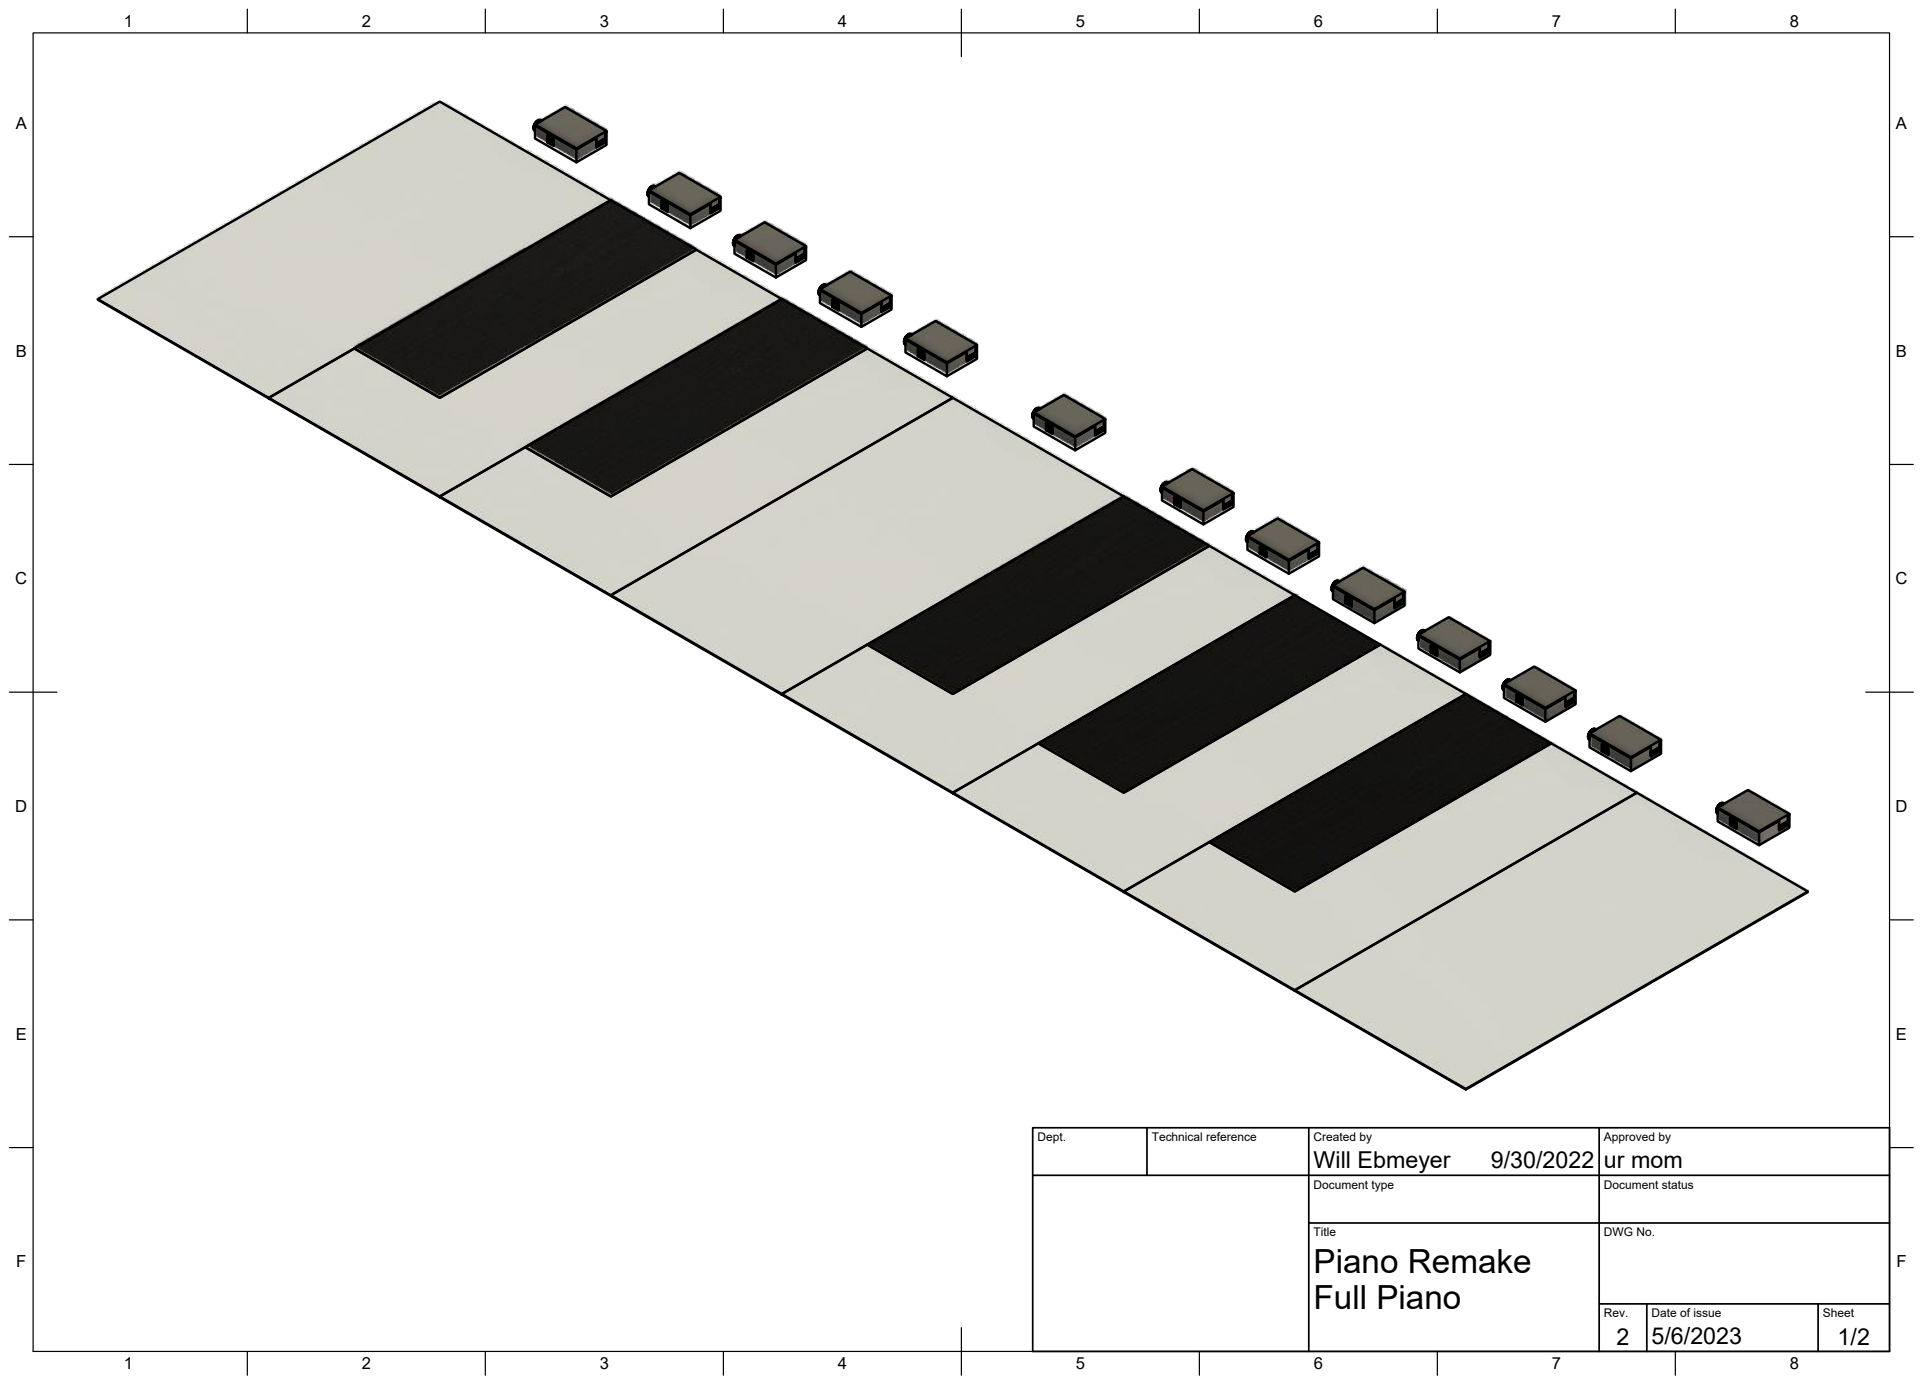
[picture p68: page 1]
Title; DWG No.; Rev.; Date of issue; Sheet; Full Piano; Piano Remake

Dept. | Technical reference | Created by Will Ebmeyer 9/30/2022 | Approved by ur mom

Document type | Document status

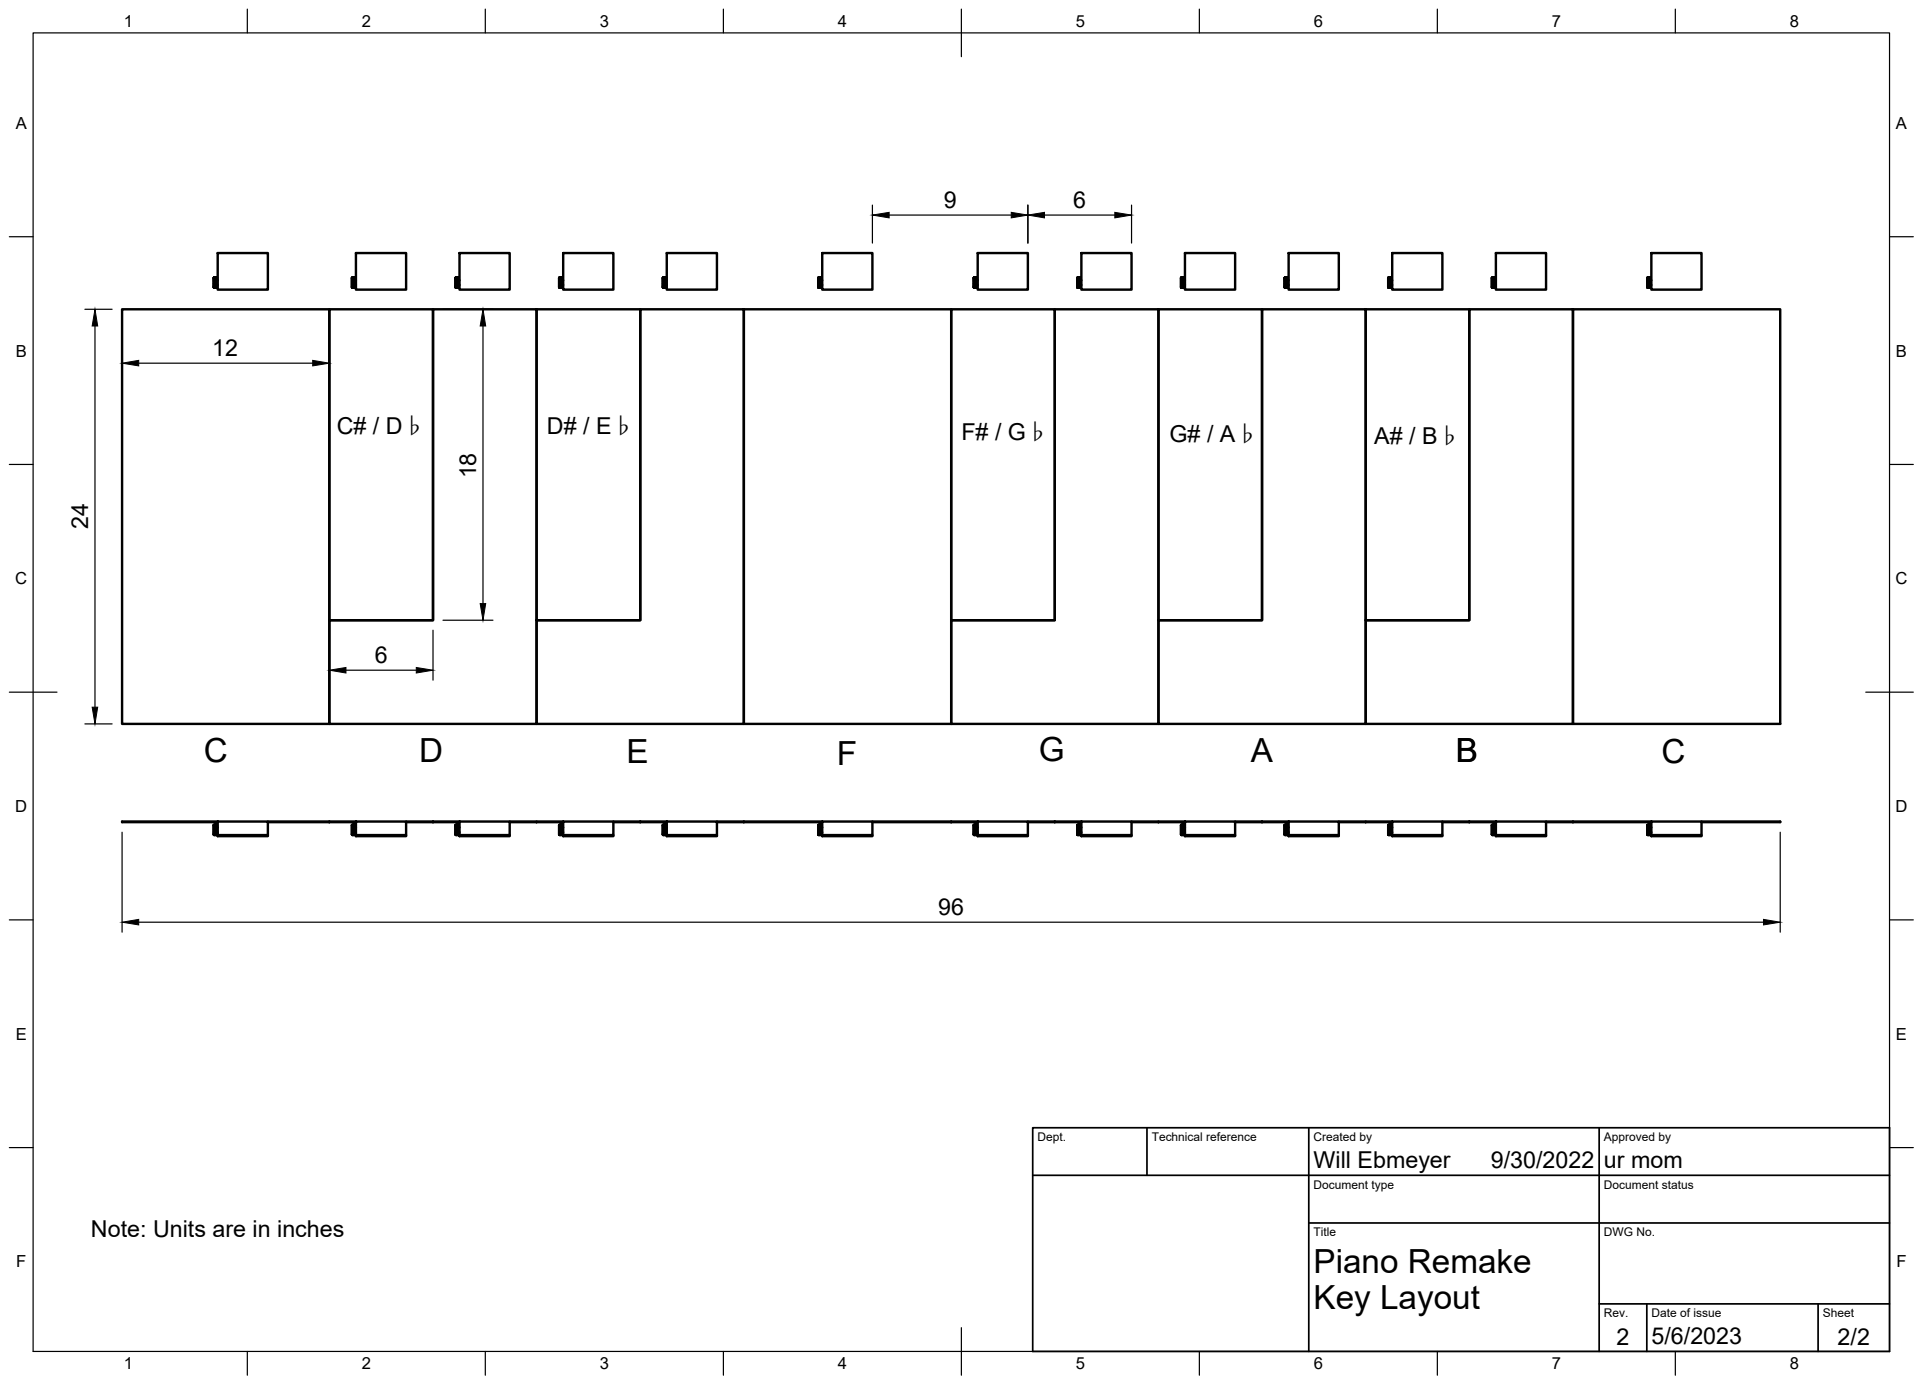
[picture p69: page 2]
Title; DWG No.; Rev.; Date of issue; Sheet; Key Layout; Piano Remake

Dept. | Technical reference | Created by Will Ebmeyer 9/30/2022 | Approved by ur mom

Document type | Document status

Note: Units are in inches
