Sciguy324/Big-Piano-2/Source Files/Potentiometer Knob Drawing.pdf

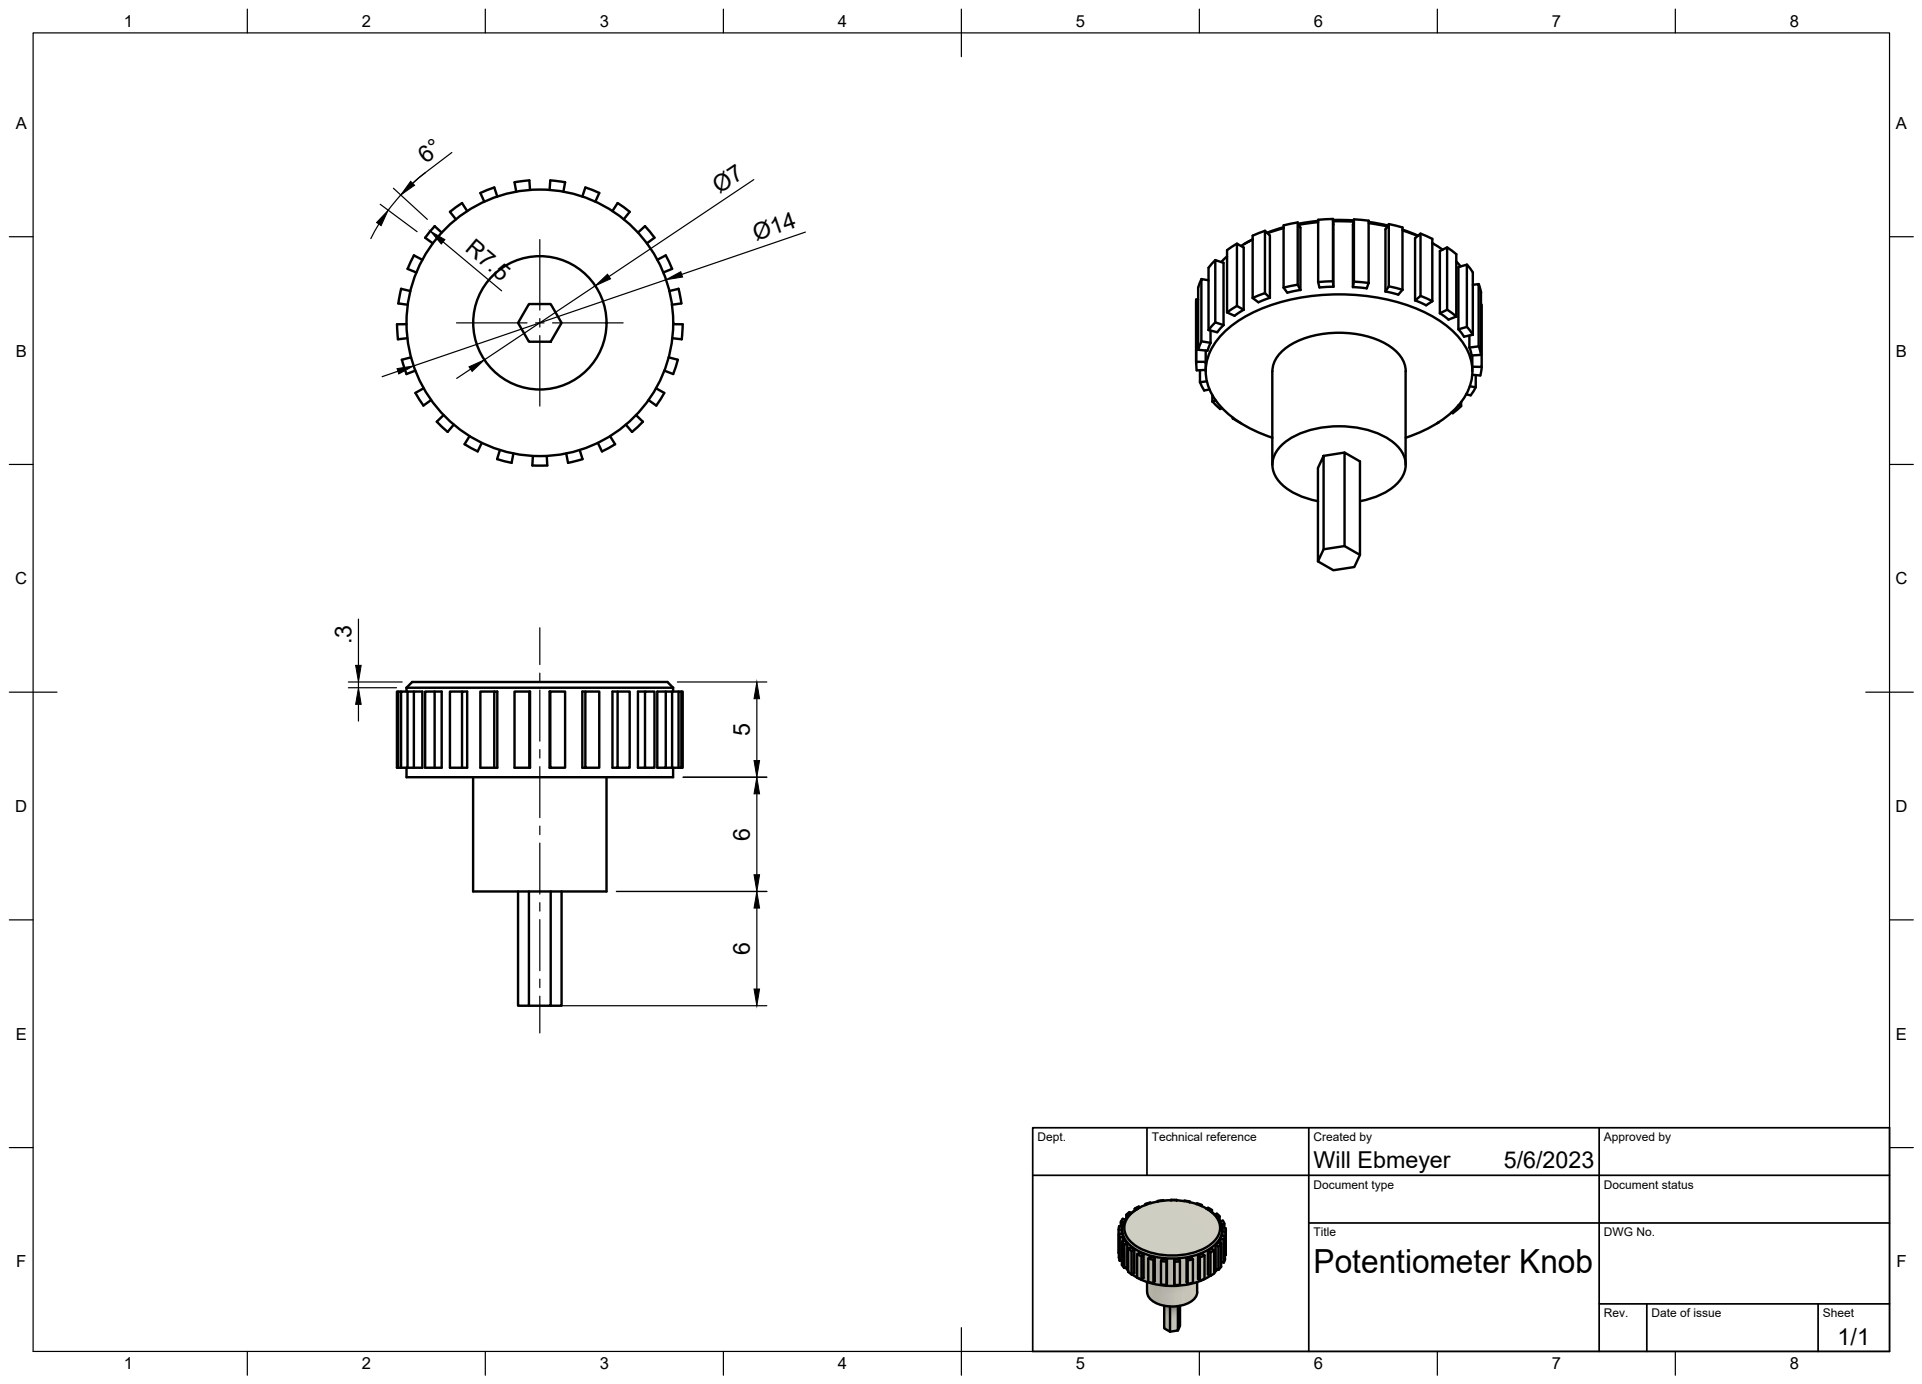
[picture p70: page 1]
Title; DWG No.; Rev.; Date of issue; Sheet; Potentiometer Knob

Dept. | Technical reference | Created by Will Ebmeyer 5/6/2023 | Approved by

Document type | Document status
