Sciguy324/Big-Piano-2/Source Files/Component Layout.asc

A1: 
D1: diode
D2: diode
FSR: Potentiometer
POT: Potentiometer
R1: res; 1k
R2: res; 332k
U1: 
X1: 
X2: Vcc
X3: jumper
X4: jumper
X5: jumper
X6: jumper
X7: jumper
X8: jumper
X9: jumper
X10: jumper
X11: jumper
X12: jumper
X13: jumper
X14: jumper
X15: jumper
X16: jumper
X17: jumper
X18: jumper
X19: jumper
X20: jumper
X21: jumper
X22: jumper
X23: jumper
X24: jumper
X25: jumper
X26: jumper
X27: jumper
X28: jumper
X29: jumper
X30: jumper
X31: jumper
Named nets: 0, DATA, CLK, SELECT, Vcc, GND
