Sciguy324/Big-Piano-2/Source Files/Individual Circuit Diagram.asc

A1: dflop
Q1: npn
Rin: res
RL: res
X1: jumper
X2: jumper
X3: jumper
Named nets: CLKin, SELECTin, DATAout, Key, CLKout, DATAin, 0
